brennoms/Arduino-sistema-embarcado-para-reservatorios/assets/20261112 (4).jpg

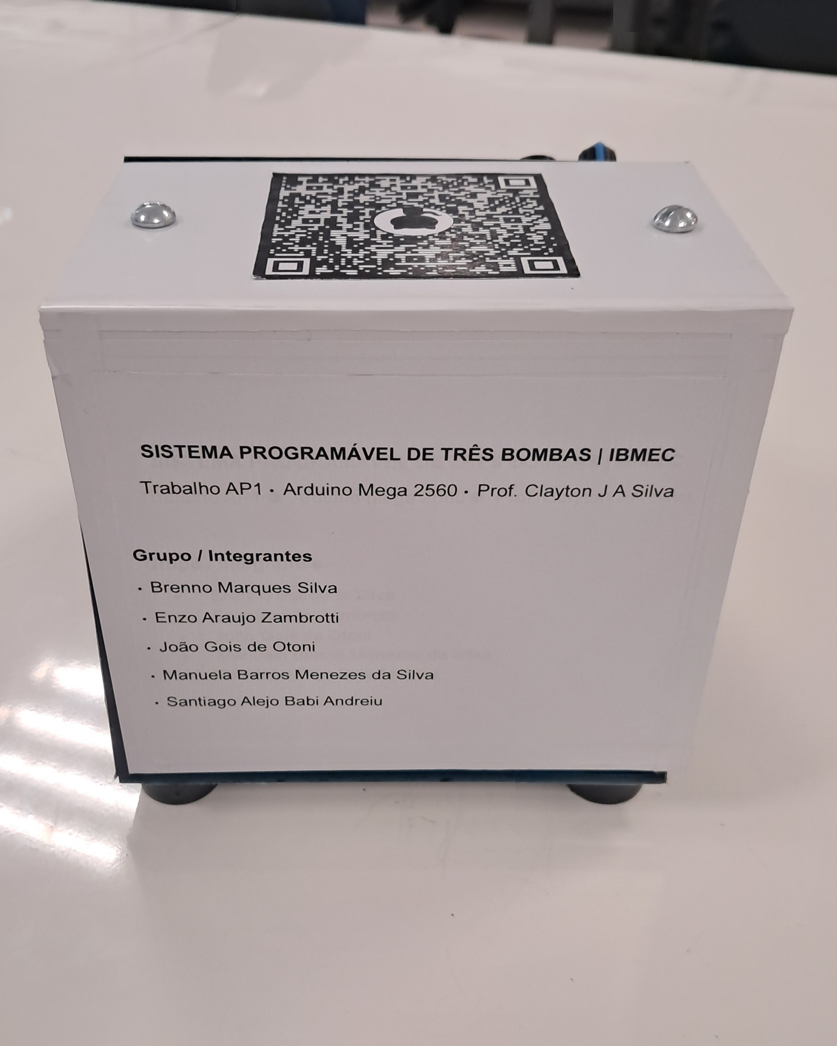
assets/20261112 (4).jpg
