brennoms/Arduino-sistema-embarcado-para-reservatorios/assets/20261112 (3).jpg

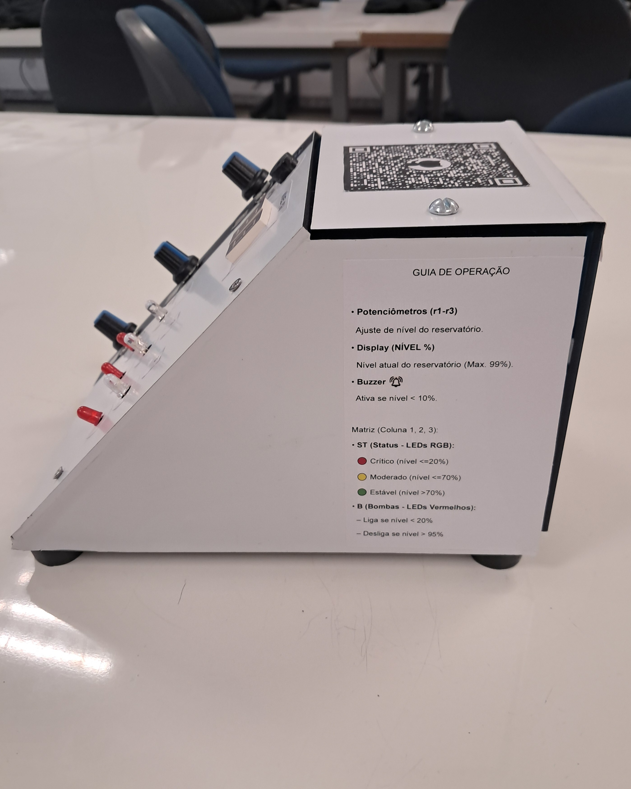
assets/20261112 (3).jpg
