brennoms/Arduino-sistema-embarcado-para-reservatorios/diagramas/case para arduino/creditos.md

## Créditos

Case/suporte para Arduino baseado no modelo
["Arduino Holder"](https://cults3d.com/pt/modelo-3d/ferramentas/arduino-holder/makes),
de [Ivan_N](https://cults3d.com/@Ivan_N).

Licença original: [Creative Commons Atribuição (CC BY 4.0)](https://creativecommons.org/licenses/by/4.0/).

O modelo foi utilizado para impressão 3D neste projeto.
Nenhuma modificação foi feita no modelo original.
