brennoms/Arduino-sistema-embarcado-para-reservatorios/assets/20261112 (1).jpg

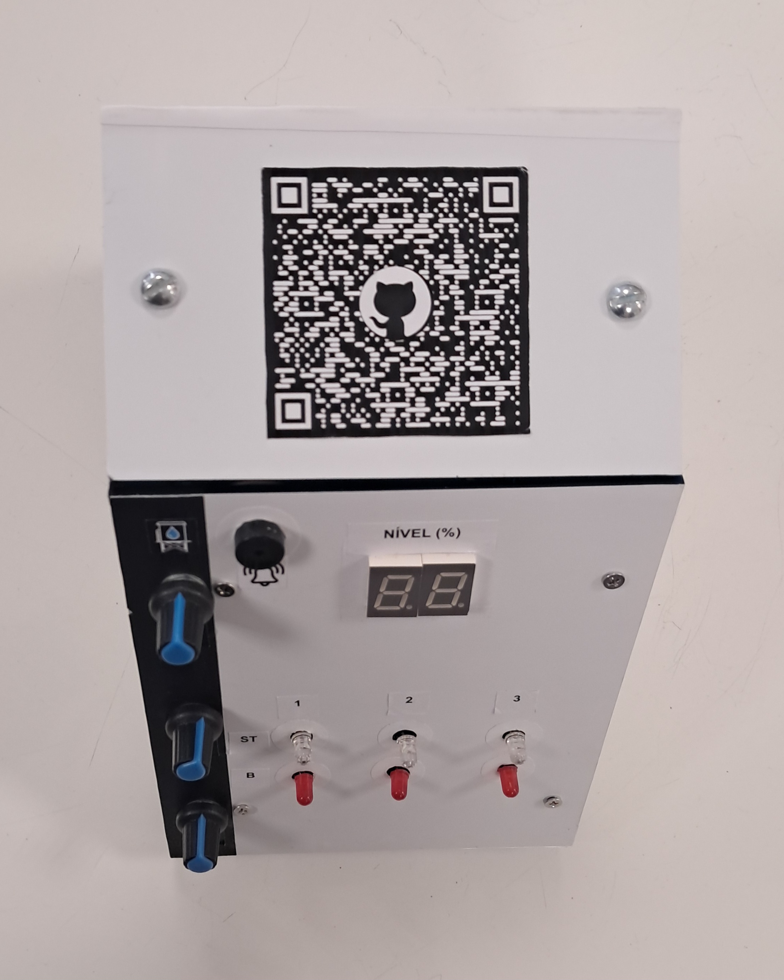
assets/20261112 (1).jpg
