brennoms/Arduino-sistema-embarcado-para-reservatorios/assets/20261112 (2).jpg

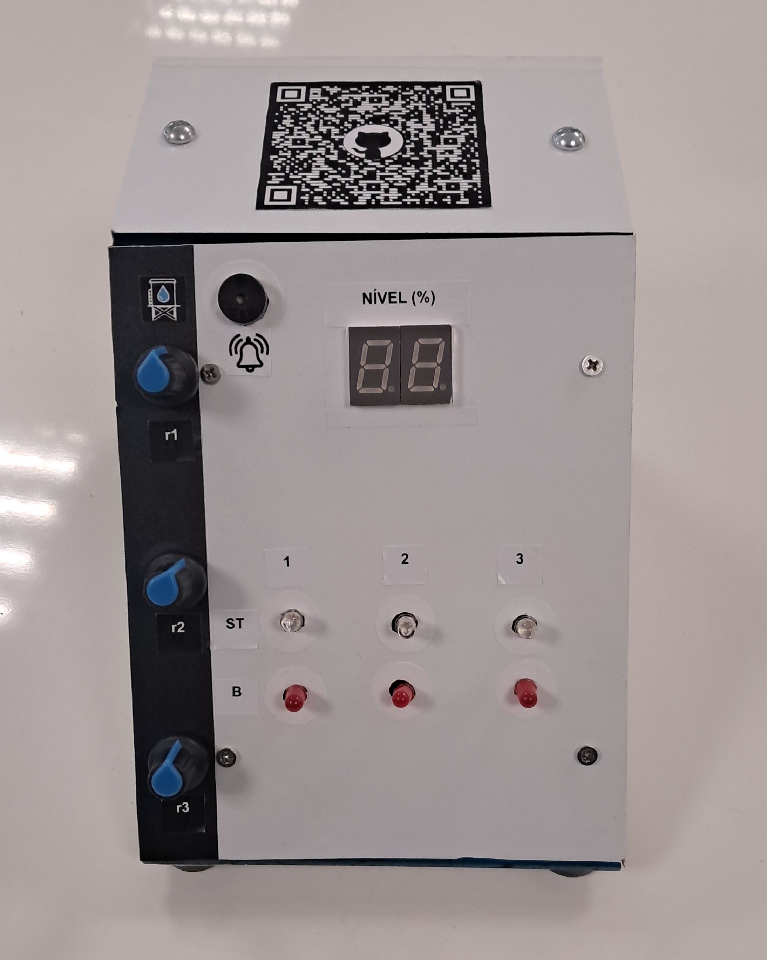
assets/20261112 (2).jpg
