brennoms/Arduino-sistema-embarcado-para-reservatorios/assets/20261112 (5).jpg

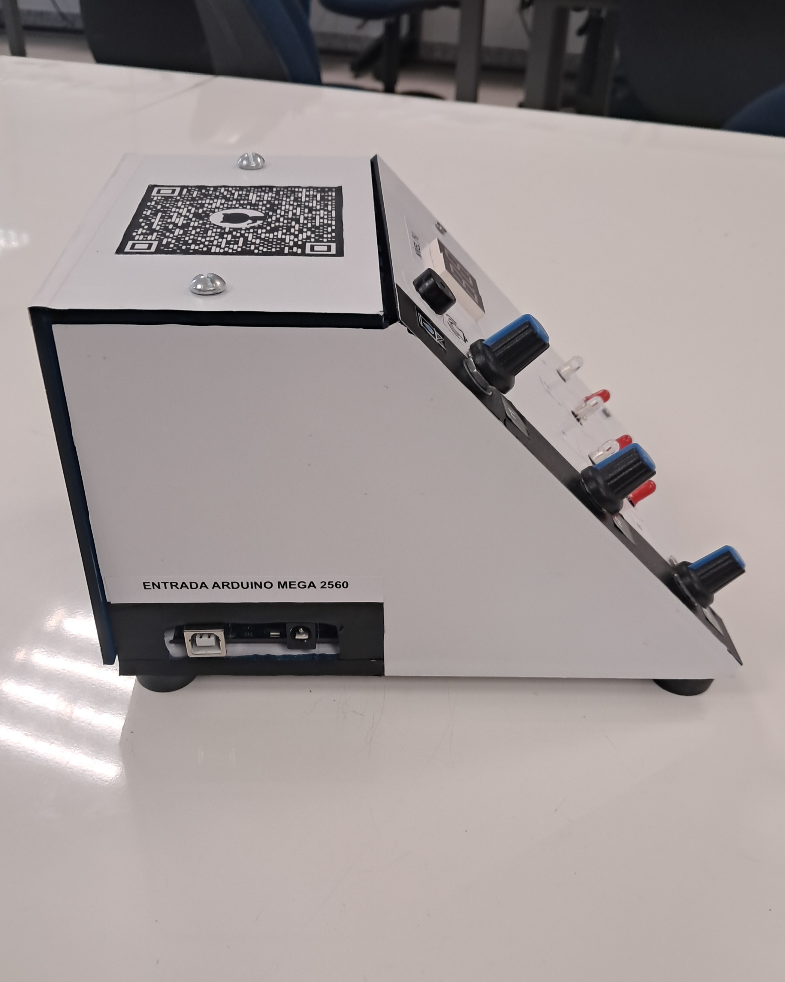
assets/20261112 (5).jpg
