brennoms/Arduino-sistema-embarcado-para-reservatorios/diagramas/Diagrama Arduino Wokwi.jpg

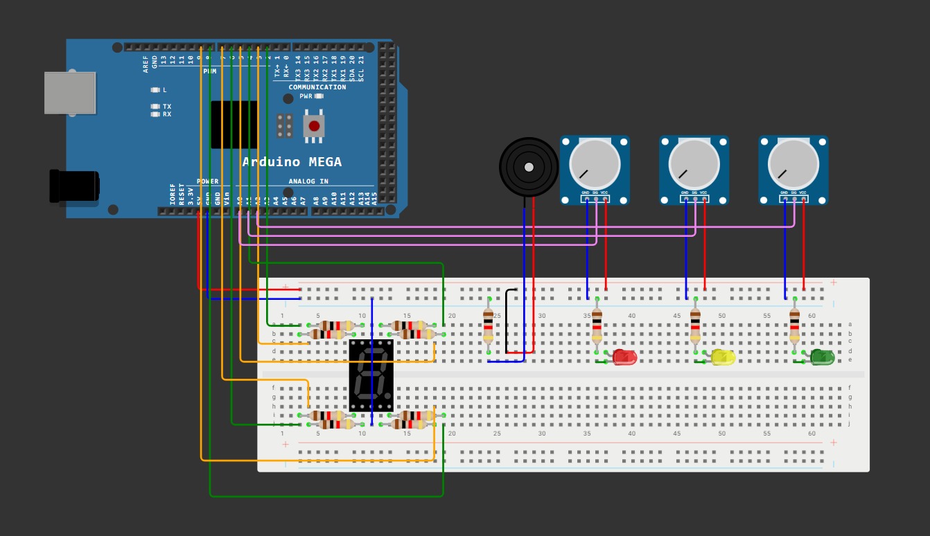
diagramas/Diagrama Arduino Wokwi.jpg
