brennoms/Arduino-sistema-embarcado-para-reservatorios/diagramas/case para arduino/arduino.stl

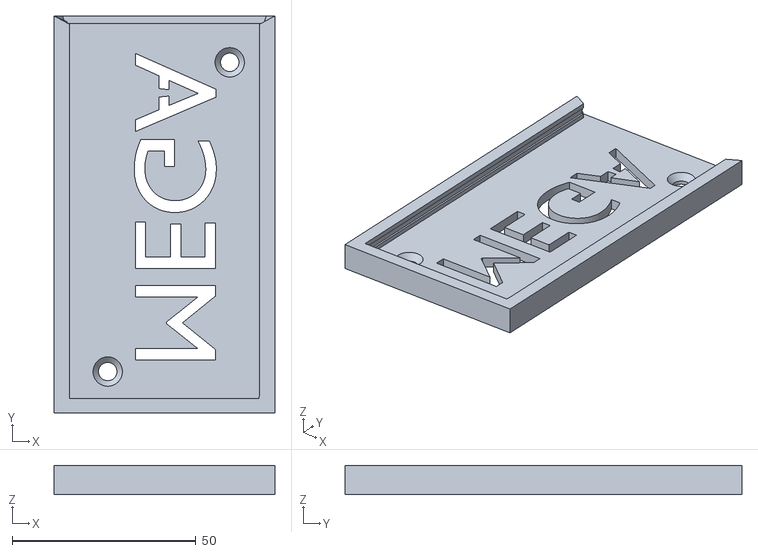
[picture p7: CAD file, 2026-11-08]
diagramas/case para arduino/arduino.stl
60.0 x 108.0 x 7.90
