brennoms/Arduino-sistema-embarcado-para-reservatorios/diagramas/Plano de corte.dxf

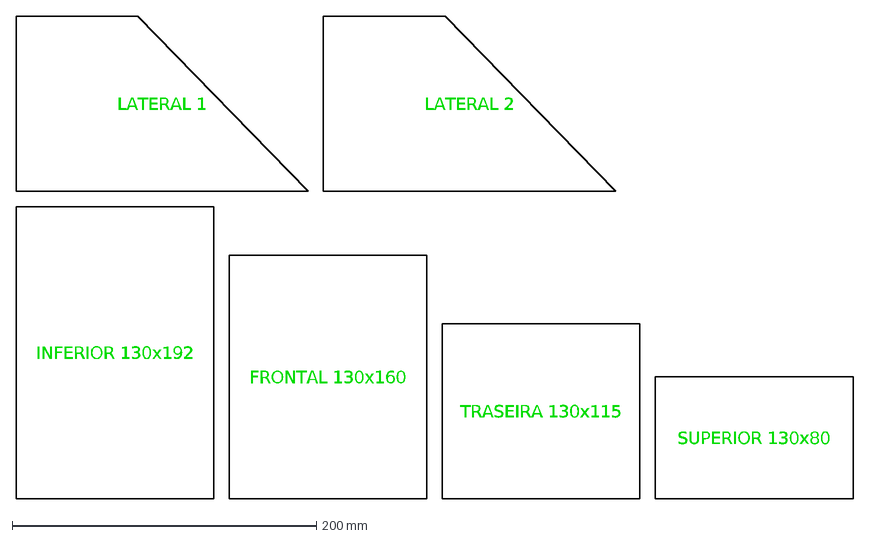
[picture p8: CAD file, 2026-11-06]
diagramas/Plano de corte.dxf
INFERIOR 130x192
FRONTAL 130x160
TRASEIRA 130x115
SUPERIOR 130x80
LATERAL 1
LATERAL 2
