brennoms/Arduino-sistema-embarcado-para-reservatorios/diagramas/diagrama_ligacoes.pdf

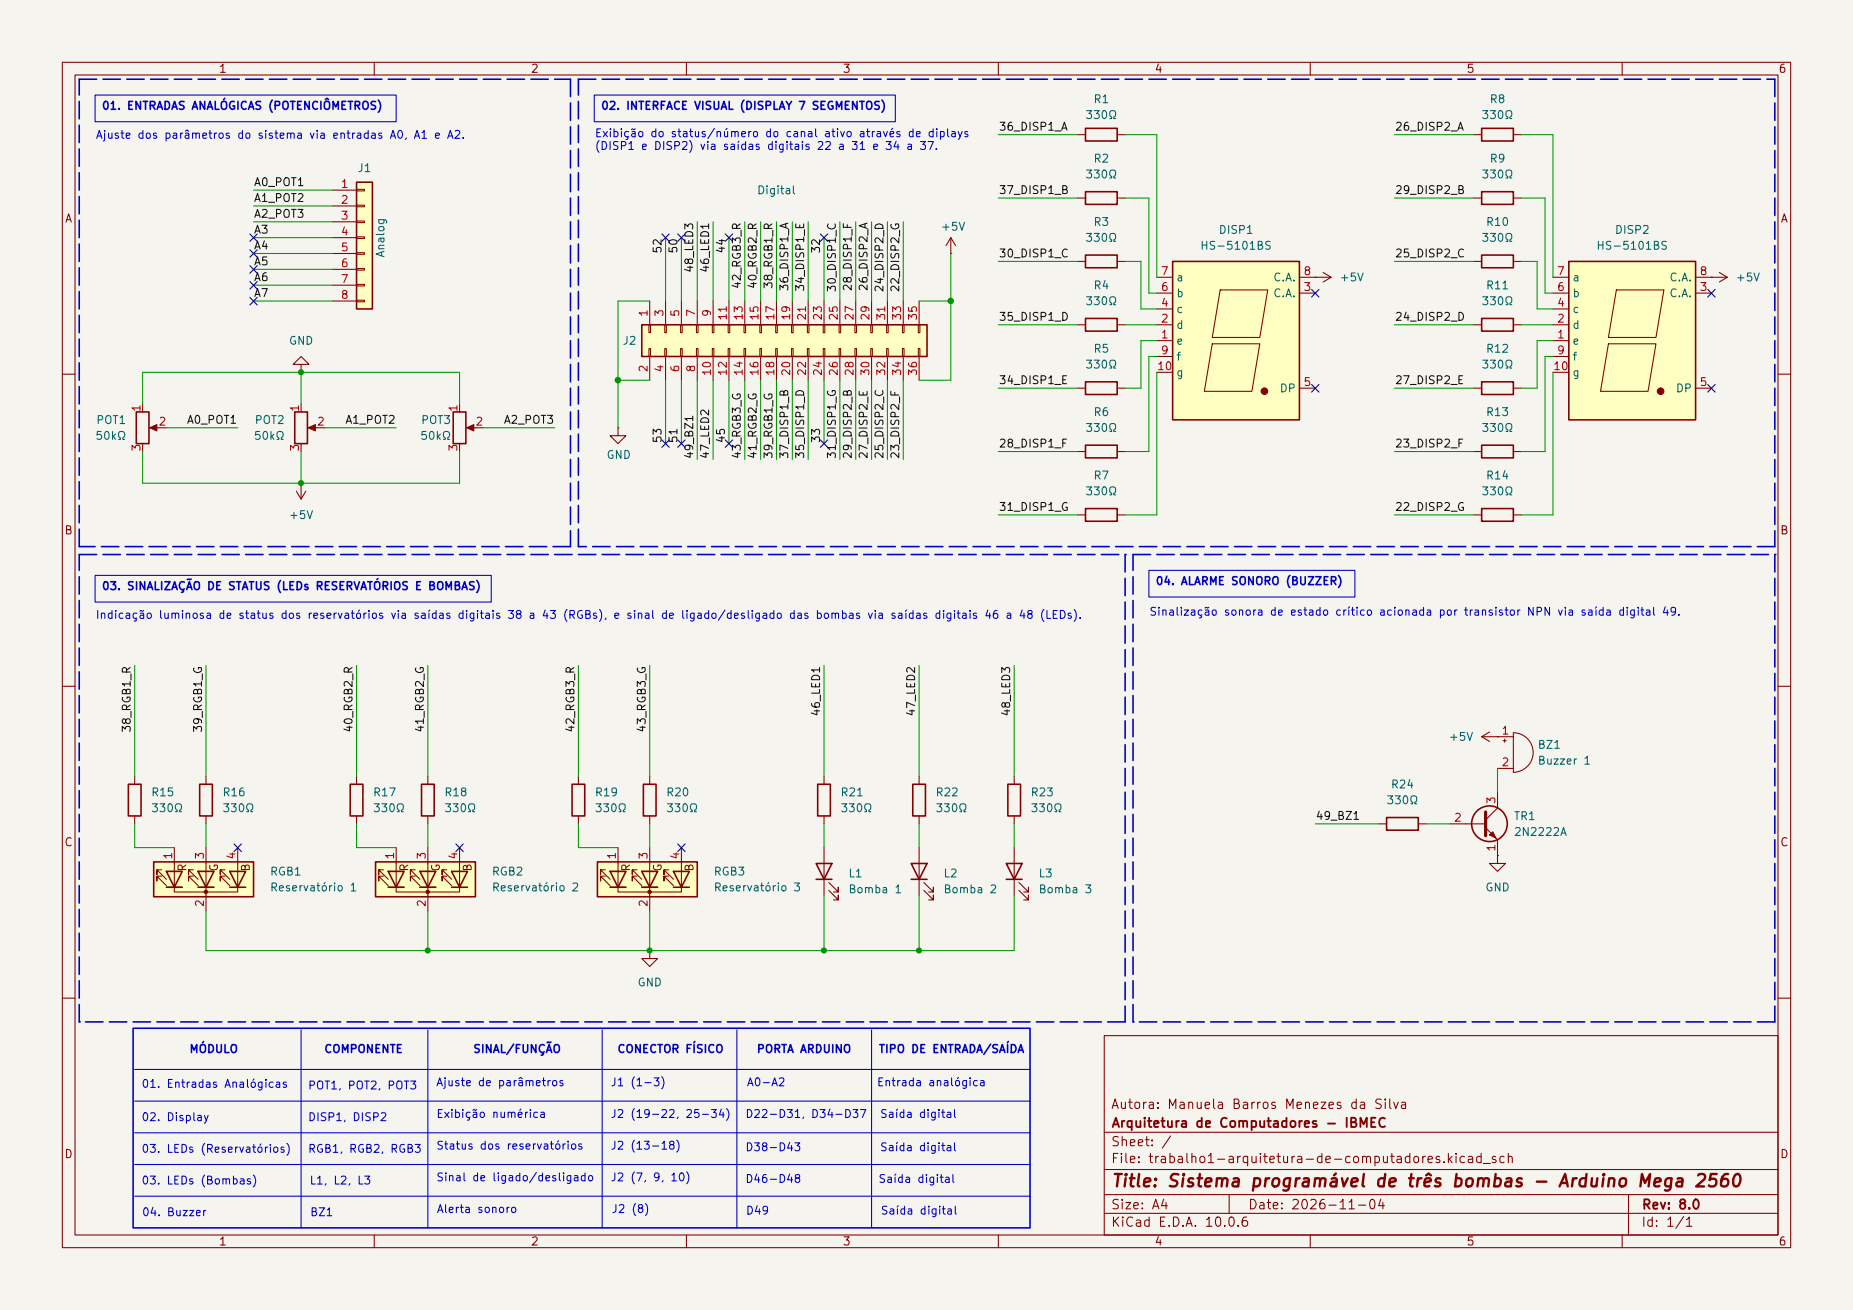
[picture p9: page 1]
