brennoms/Arduino-sistema-embarcado-para-reservatorios/diagramas/Trabalho 1 - Arquitetura de Computadores.pdf

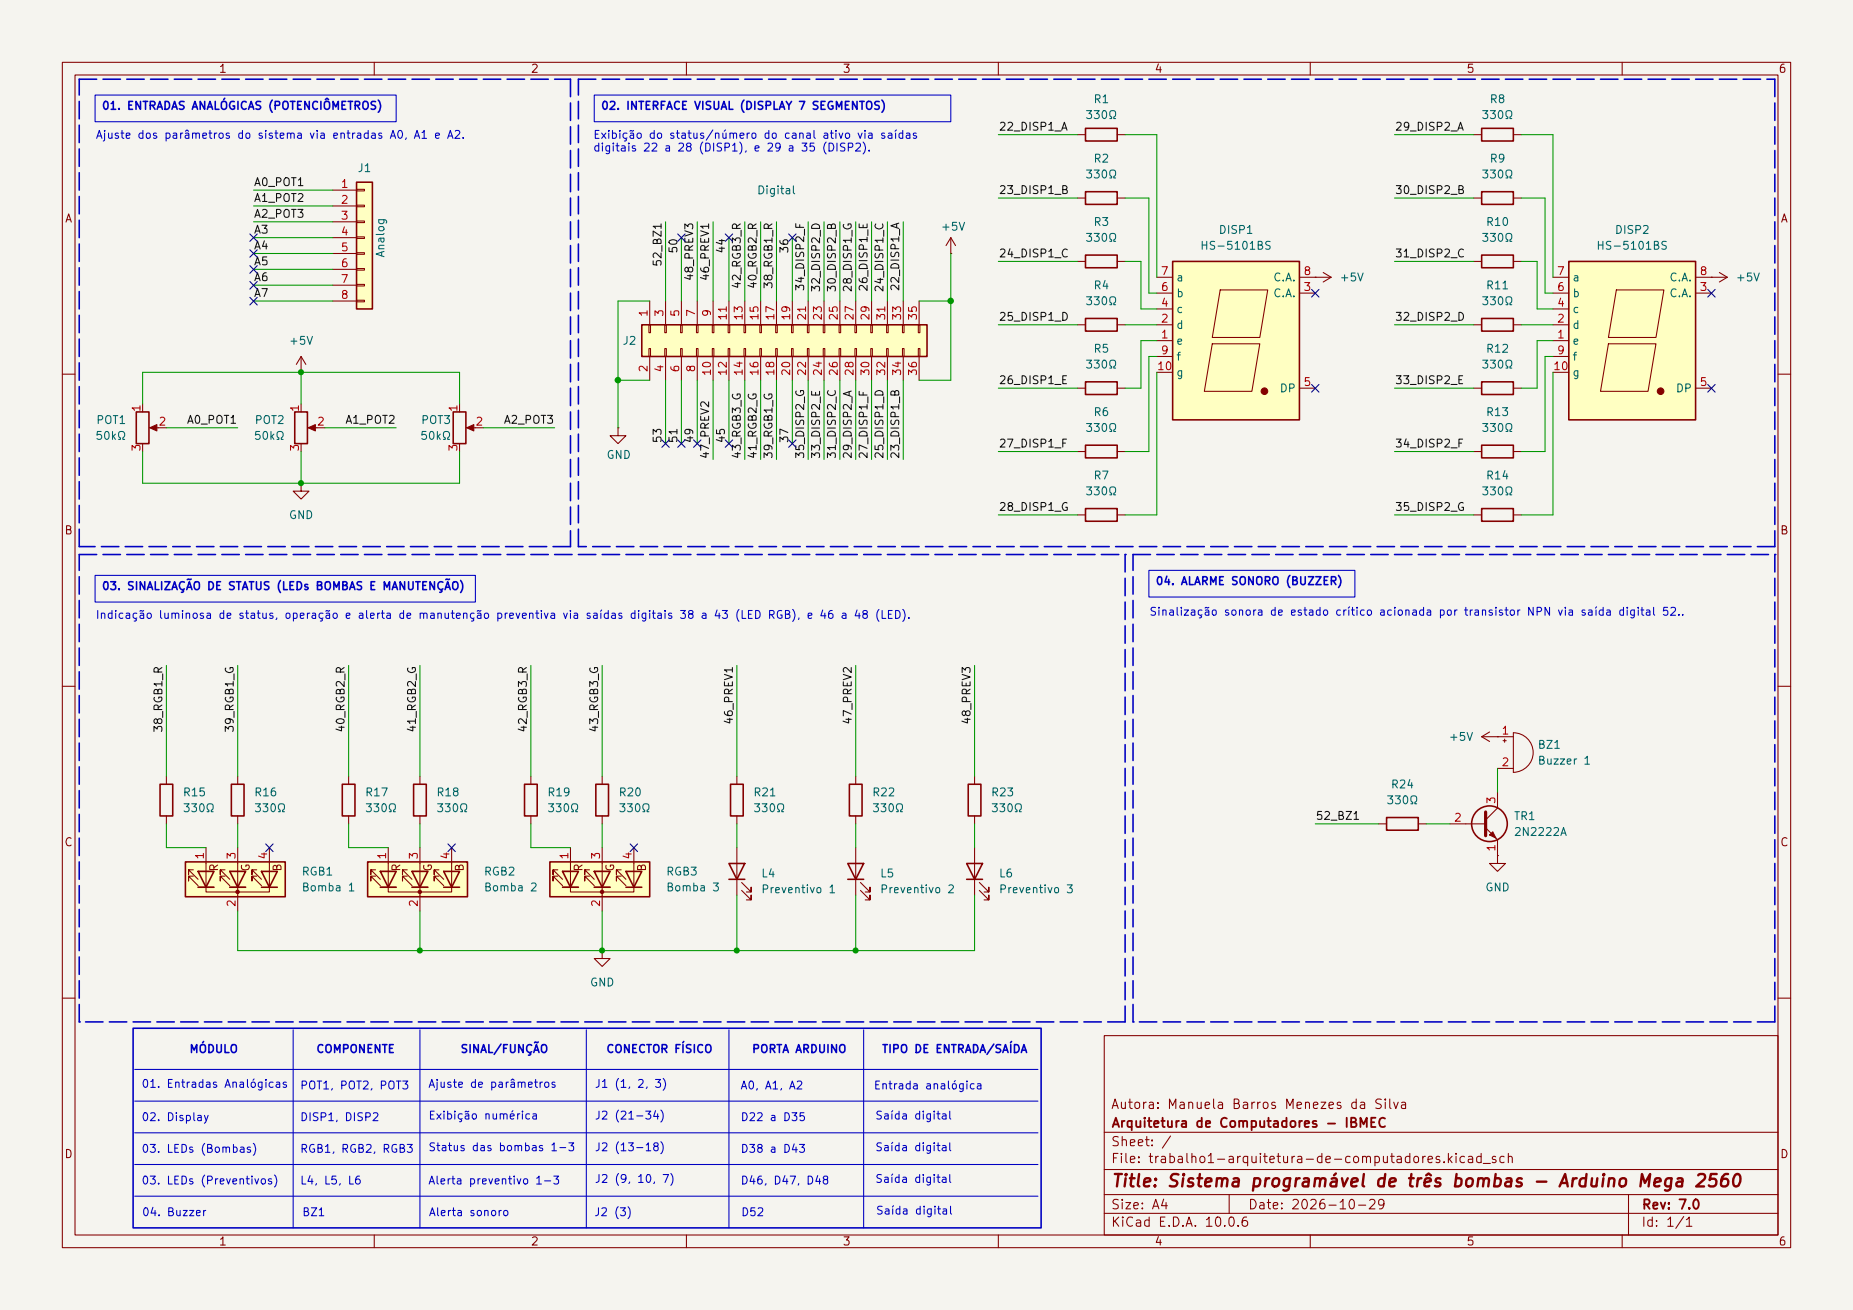
[picture p10: page 1]
