brennoms/Arduino-sistema-embarcado-para-reservatorios/diagramas/projeto kicad/trabalho1-arquitetura-de-computadores.kicad_sch

## KiCad design diagramas/projeto kicad/trabalho1-arquitetura-de-computadores.kicad_sch (2026-11-06)

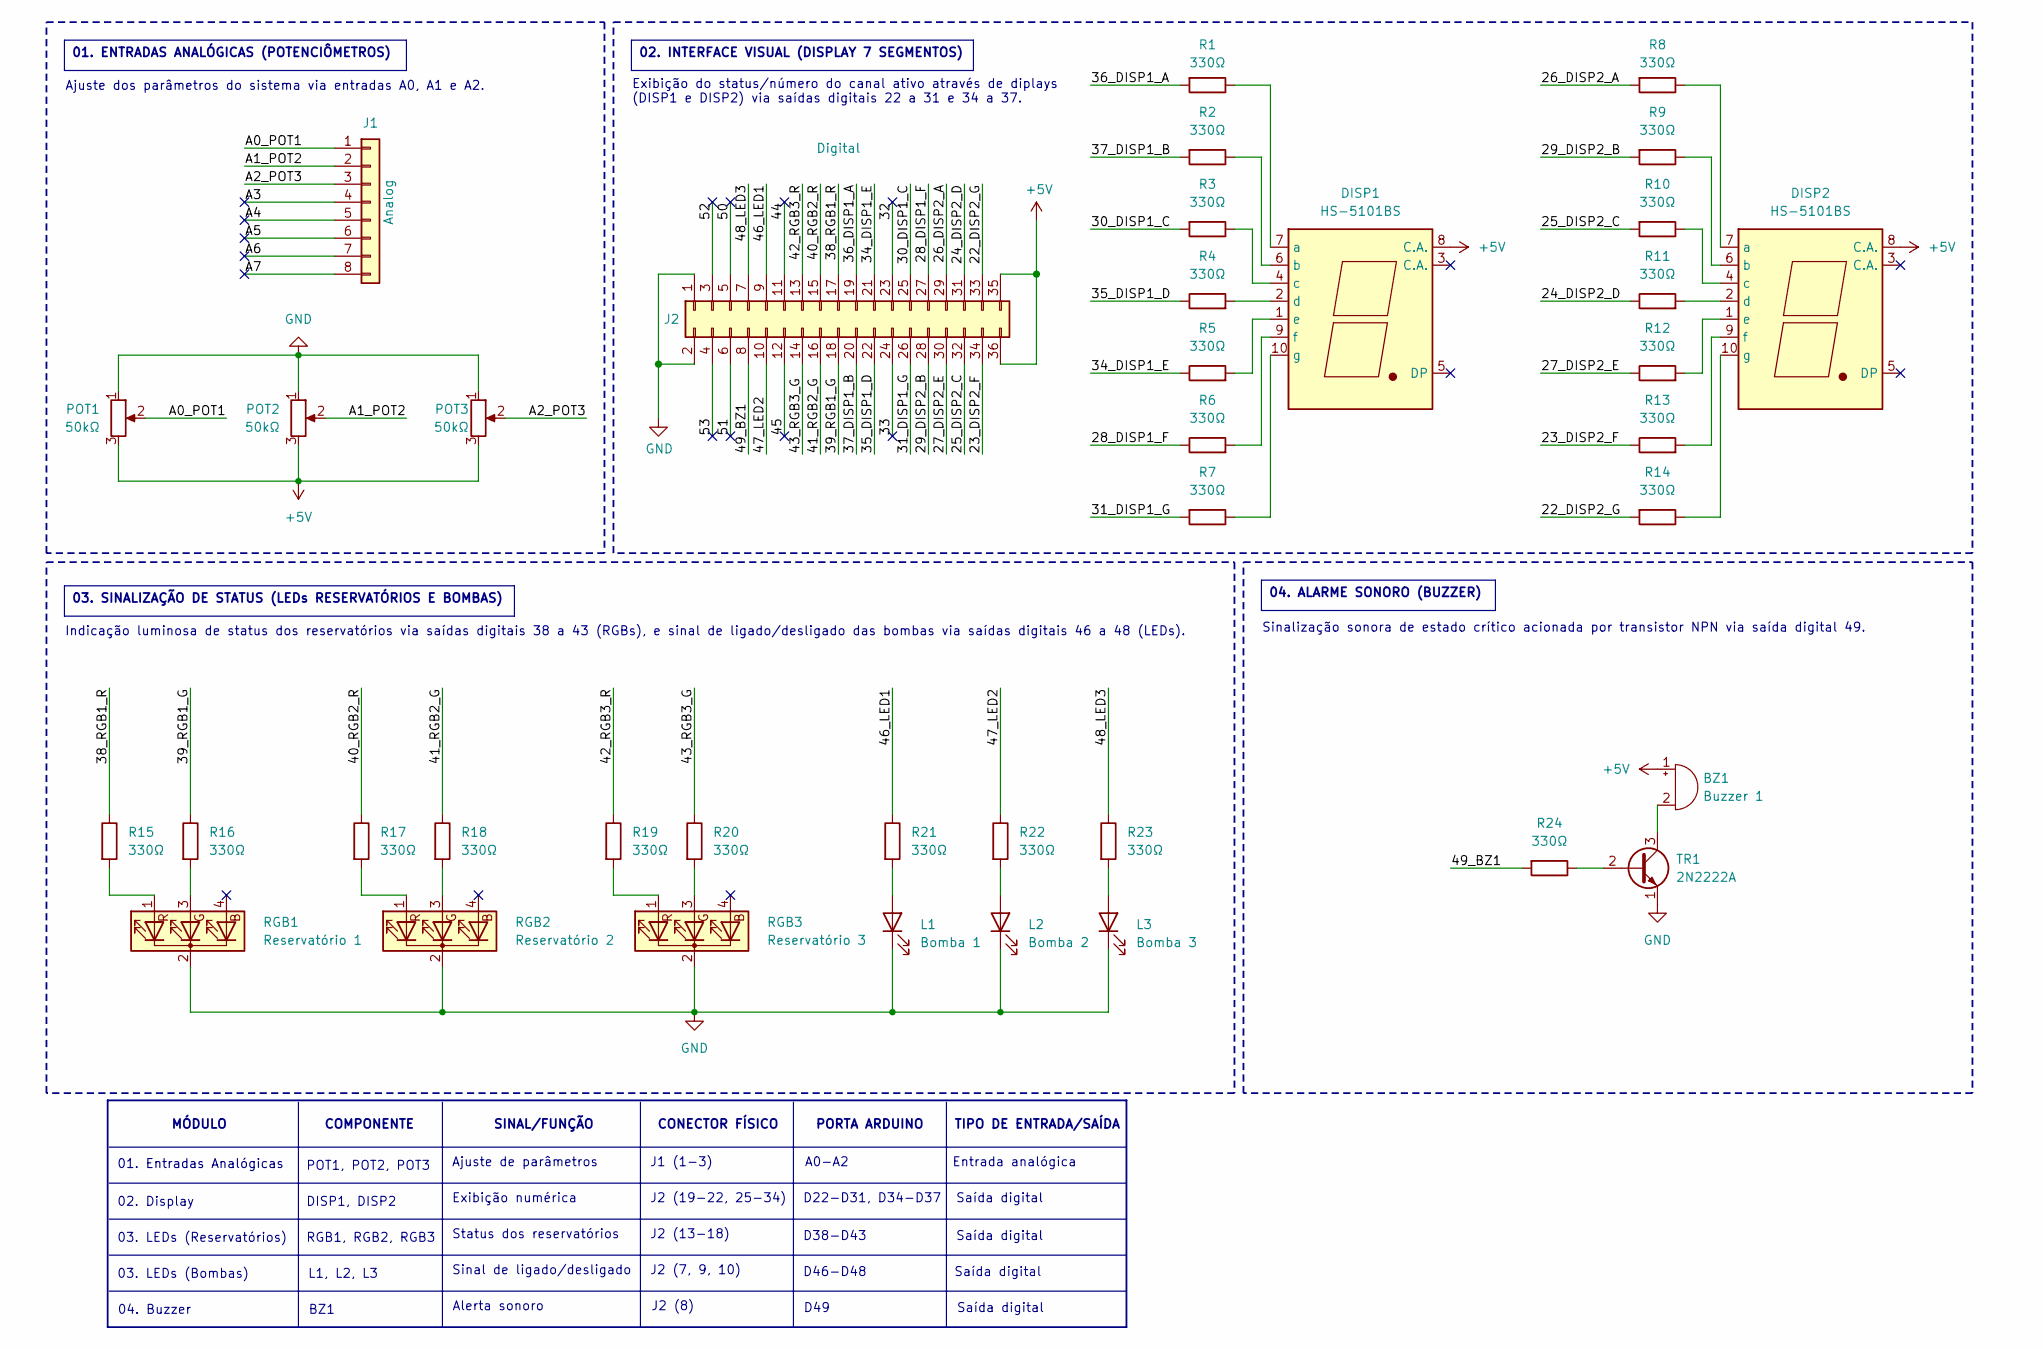
[picture p11: schematic trabalho1-arquitetura-de-computadores.kicad_sch]

Parts:
BZ1: Buzzer 1
DISP1, DISP2: HS-5101BS; 7SegmentLED_LTS6760_LTS6780
J1: Analog; PinSocket_1x08_P2.54mm_Vertical
J2: Digital; PinSocket_2x18_P2.54mm_Vertical
L1: Bomba 1
L2: Bomba 2
L3: Bomba 3
POT1: 50kΩ; TSSOP-20_4.4x6.5mm_P0.65mm
POT2, POT3: 50kΩ
R1, R2, R3, R4, R5, R6, R7, R8, R9, R10, R11, R12, R13, R14, R16, R17, R18, R19, R20, R21, R22, R23: 330Ω
R15: 330Ω; 7SegmentLED_LTS6760_LTS6780
R24: 330Ω; TO-92_Inline
RGB1: Reservatório 1; TO-92_Inline
RGB2: Reservatório 2
RGB3: Reservatório 3
TR1: 2N2222A; TO-92_Inline

Connections:
22_DISP2_G: J2.33, R14.2
23_DISP2_F: J2.34, R13.1
24_DISP2_D: J2.31, R11.1
25_DISP2_C: J2.32, R10.2
26_DISP2_A: J2.29, R8.2
27_DISP2_E: J2.30, R12.1
28_DISP1_F: J2.27, R6.1
29_DISP2_B: J2.28, R9.2
30_DISP1_C: J2.25, R3.2
31_DISP1_G: J2.26, R7.2
32: J2.23
33: J2.24
34_DISP1_E: J2.21, R5.1
35_DISP1_D: J2.22, R4.1
36_DISP1_A: J2.19, R1.2
37_DISP1_B: J2.20, R2.2
38_RGB1_R: J2.17, R15.1
39_RGB1_G: J2.18, R16.1
40_RGB2_R: J2.15, R17.1
41_RGB2_G: J2.16, R18.1
42_RGB3_R: J2.13, R19.1
43_RGB3_G: J2.14, R20.1
44: J2.11
45: J2.12
46_LED1: J2.9, R21.1
47_LED2: J2.10, R22.1
48_LED3: J2.7, R23.1
49_BZ1: J2.8, R24.2
50: J2.5
51: J2.6
52: J2.3
53: J2.4
+5V: BZ1.1 (+), DISP1.8 (C.A.), DISP2.8 (C.A.), J2.35, J2.36, POT1.3, POT2.3, POT3.3
A0_POT1: J1.1, POT1.2
A1_POT2: J1.2, POT2.2
A2_POT3: J1.3, POT3.2
A3: J1.4
A4: J1.5
A5: J1.6
A6: J1.7
A7: J1.8
GND: J2.1, J2.2, L1.1 (K), L2.1 (K), L3.1 (K), POT1.1, POT2.1, POT3.1, RGB1.2 (K), RGB2.2 (K), RGB3.2 (K), TR1.1 (E)
unnamed: BZ1.2 (-), TR1.3 (C)
unnamed: DISP1.1 (e), R5.2
unnamed: DISP1.2 (d), R4.2
unnamed: DISP1.4 (c), R3.1
unnamed: DISP1.6 (b), R2.1
unnamed: DISP1.7 (a), R1.1
unnamed: DISP1.9 (f), R6.2
unnamed: DISP1.10 (g), R7.1
unnamed: DISP2.1 (e), R12.2
unnamed: DISP2.2 (d), R11.2
unnamed: DISP2.4 (c), R10.1
unnamed: DISP2.6 (b), R9.1
unnamed: DISP2.7 (a), R8.1
unnamed: DISP2.9 (f), R13.2
unnamed: DISP2.10 (g), R14.1
unnamed: L1.2 (A), R21.2
unnamed: L2.2 (A), R22.2
unnamed: L3.2 (A), R23.2
unnamed: R15.2, RGB1.1 (RA)
unnamed: R16.2, RGB1.3 (GA)
unnamed: R17.2, RGB2.1 (RA)
unnamed: R18.2, RGB2.3 (GA)
unnamed: R19.2, RGB3.1 (RA)
unnamed: R20.2, RGB3.3 (GA)
unnamed: R24.1, TR1.2 (B)

Notes on the sheet:
PORTA ARDUINO
03. LEDs (Bombas)
Ajuste de parâmetros
TIPO DE ENTRADA/SAÍDA
L1, L2, L3
D46-D48
BZ1
MÓDULO
J1 (1-3)
Ajuste dos parâmetros do sistema via entradas A0, A1 e A2.
04. Buzzer
Sinalização sonora de estado crítico acionada por transistor NPN via saída digital 49.
01. Entradas Analógicas
J2 (8)
03. LEDs (Reservatórios)
CONECTOR FÍSICO
Indicação luminosa de status dos reservatórios via saídas digitais 38 a 43 (RGBs), e sinal de ligado/desligado das bombas via saídas digitais 46 a 48 (LEDs).
J2 (13-18)
RGB1, RGB2, RGB3
Saída digital
D38-D43
J2 (19-22, 25-34)
D49
Exibição numérica
A0-A2
Alerta sonoro
Exibição do status/número do canal ativo através de diplays (DISP1 e DISP2) via saídas digitais 22 a 31 e 34 a 37.
Sinal de ligado/desligado
D22-D31, D34-D37
02. Display
Entrada analógica
J2 (7, 9, 10)
COMPONENTE
Status dos reservatórios
DISP1, DISP2
POT1, POT2, POT3
SINAL/FUNÇÃO
03. SINALIZAÇÃO DE STATUS (LEDs RESERVATÓRIOS E BOMBAS)
02. INTERFACE VISUAL (DISPLAY 7 SEGMENTOS)
04. ALARME SONORO (BUZZER)
01. ENTRADAS ANALÓGICAS (POTENCIÔMETROS)
