brennoms/Arduino-sistema-embarcado-para-reservatorios/scripts/ArquiteturaSimulada.ino

//Autor: Brenno Marques Silva @brennoms

#include <Arduino.h>
#include <EEPROM.h>
#include <stdint.h>
#include <stdbool.h>
#include <string.h>
#include <stdlib.h>

// ============================================================================
// ARQUITETURA SIMULADA — SISTEMA PROGRAMÁVEL DE TRÊS BOMBAS (COM SECDED)
//
// Palavra lógica da ISA: 18 bits
//   bits 17..14 -> opcode (4 bits)
//   bits 13..7  -> operando 1 (7 bits)
//   bits 6..0   -> operando 2 (7 bits)
//
// Proteção de Memória SECDED (Hamming Estendido 24,18):
//   - 18 bits de dados da ISA (D0..D17)
//   - 5 bits de paridade de Hamming (P1, P2, P4, P8, P16) nas posições 1,2,4,8,16
//   - 1 bit de paridade global (P0) na posição 0
//   - Palavra física armazenada em MEM_PROG: 24 bits (bits 23..0 do uint32_t)
//
// Memória de programa:
//   128 posições: 0x00 .. 0x7F
//   uma palavra física de 24 bits (18 bits ISA + 6 bits ECC) por posição
// ============================================================================

// ============================== Constantes =================================
#define BITS_OPCODE        4
#define BITS_OPERANDO      7
#define BITS_PALAVRA       18
#define BITS_ECC           6
#define BITS_FISICOS       24
#define TAM_MEMORIA        128
#define VALOR_MAX_OPERANDO 0x7F
#define MAX_PERCENTUAL     100

// Ajustado para 127 para manter coerência estrita com o campo OP1 de 7 bits (12,7 s).
#define MAX_WAIT_TICKS     127
#define WAIT_MS            100UL

#define OPCODE_SHIFT       14
#define OPERANDO1_SHIFT    7
#define MASCARA_7_BITS     0x7FUL
#define MASCARA_PALAVRA    0x3FFFFUL
#define MASCARA_FISICA     0xFFFFFFUL

#define LINE_BUFFER_SIZE   96
#define EEPROM_MAGIC       0xA55A
#define EEPROM_HEADER_SIZE 4

// Limiares de nível para os LEDs RGB
#define LIMIAR_CRITICO     20
#define LIMIAR_RAZOAVEL    70

// ================================ Pinagem ===================================
const uint8_t PIN_NIVEL[3] = {A0, A1, A2};
const uint8_t PIN_BOMBA[3] = {46, 47, 48};

// Pinos dos 3 LEDs RGB (canais vermelho e verde)
const uint8_t PIN_RGB_R[3] = {38, 40, 42};
const uint8_t PIN_RGB_G[3] = {39, 41, 43};

const uint8_t PIN_BUZZER = 49;
const uint8_t PIN_DISPLAY_DEZENAS[7] = {36, 37, 30, 35, 34, 28, 31}; // DISP1: a,b,c,d,e,f,g
const uint8_t PIN_DISPLAY_UNIDADES[7] = {26, 29, 25, 24, 27, 23, 22}; // DISP2: a,b,c,d,e,f,g

// Os displays HS-5101BS do esquema têm anodo comum.
#define DISPLAY_ACTIVE_HIGH false

// ============================= Códigos da ISA ===============================
enum Opcode : uint8_t {
    OP_READ = 0,
    OP_ON,
    OP_OFF,
    OP_ALARM,
    OP_LED,
    OP_INFO,
    OP_SILENCE,
    OP_LEDOFF,
    OP_CMP,
    OP_JMP,
    OP_JL,
    OP_JE,
    OP_JG,
    OP_WAIT,
    OP_HALT,
    OP_REG = 15
};

const Opcode OP_INVALID = (Opcode)16;
const uint8_t REG_SUBOP_CMP = 0;
const uint8_t REG_SUBOP_JUMP = 1;
const uint8_t REG_SUBOP_SUM = 2;

const char *NOME_OPCODE[16] = {
    "READ", "ON", "OFF", "ALARM", "LED", "INFO", "SILENCE", "LEDOFF",
    "CMP", "JMP", "JL", "JE", "JG", "WAIT", "HALT", "REG"
};

// ============================ Sinais de memória =============================
enum SinalMemoria : uint8_t {
    MEM_NENHUM = 0,
    MEM_LEITURA,
    MEM_ESCRITA
};

// ============================ Estados do SECDED =============================
enum StatusSECDED : uint8_t {
    ECC_OK = 0,
    ECC_SEC_CORRIGIDO,
    ECC_DED_ERRO_DUPLO
};

const char *NOME_ECC[] = {
    "OK (Sem Erro)",
    "SEC (1 Erro Corrigido)",
    "DED (2 Erros Detectados - Falha Critica)"
};

// Mapeamento dos 18 bits de dados (D0..D17) para as posições de Hamming (1..23),
// pulando as potências de 2 (1, 2, 4, 8, 16).
const uint8_t POS_DADOS_HAMMING[BITS_PALAVRA] = {
    3,  5,  6,  7,  9,  10, 11, 12, 13,
    14, 15, 17, 18, 19, 20, 21, 22, 23
};

// ============================== Estados da UC ===============================
enum ModoExecucao : uint8_t {
    MODO_CARGA = 0,
    MODO_PARADO,
    MODO_STEP,
    MODO_AUTO,
    MODO_WAIT,
    MODO_HALT,
    MODO_ERRO
};

const char *NOME_MODO[] = {
    "CARGA", "PARADO", "STEP", "AUTO", "WAIT", "HALT", "ERRO"
};

enum FaseUC : uint8_t {
    FASE_OCIOSA = 0,
    FASE_BUSCA,
    FASE_DECODIFICA,
    FASE_EXECUTA
};

enum CorRGB : uint8_t {
    RGB_OFF = 0,
    RGB_VERMELHO,
    RGB_AMARELO,
    RGB_VERDE
};

// ============================= Registradores =================================
uint8_t  PC = 0;                       // 7 bits efetivos
uint8_t  MAR = 0;                      // endereço de memória
uint32_t MBR = 0;                      // palavra lógica de 18 bits entregue pela memória
uint32_t MBR_RAW = 0;                  // palavra física de 24 bits lida antes/depois do ECC
uint32_t IR = 0;                       // palavra completa da instrução (18 bits efetivos)

// Registradores de diagnóstico do controlador SECDED
uint8_t      ECC_SINDROME = 0;         // 5 bits (0..23)
uint8_t      ECC_PARIDADE_GLOBAL = 0;  // 1 bit (0 ou 1)
StatusSECDED ECC_STATUS = ECC_OK;
uint16_t     CONTADOR_SEC = 0;         // total de erros simples corrigidos desde o LOAD
uint16_t     CONTADOR_DED = 0;         // total de erros duplos detectados desde o LOAD

int16_t  ACC = 0;                      // resultado assinado; faixa útil -100..100
int16_t  REG = 0;                      // registrador de uso geral assinado
uint8_t  OPCODE_REG = OP_REG;
uint8_t  OP1 = 0;
uint8_t  OP2 = 0;

uint8_t  NIVEL[3] = {0, 0, 0};
bool     NIVEL_VALIDO[3] = {false, false, false};

bool FLAG_L = false;
bool FLAG_Z = false;
bool FLAG_G = false;
bool COMPARACAO_VALIDA = false;
bool FLAG_REG = false;                 // CMPREG: REG < n
bool COMPARACAO_REG_VALIDA = false;

bool BOMBA_LIGADA[3] = {false, false, false};
bool LED_HABILITADO[3] = {false, false, false};
bool ALARME_CORRETIVO[3] = {false, false, false};

// ================================ Memória ===================================
// Cada posição armazena 24 bits físicos: [23..1: Hamming(23,18)] + [0: Paridade Global P0]
uint32_t MEM_PROG[TAM_MEMORIA] = {0};
bool MEM_OCUPADA[TAM_MEMORIA] = {false};

uint16_t instrucao_atual = 0;
bool programaFinalizado = false;

uint16_t enderecoEEPROMInstrucao(uint8_t endereco) {
    return EEPROM_HEADER_SIZE + ((uint16_t)endereco * sizeof(uint32_t));
}

void gravarUInt32EEPROM(uint16_t endereco, uint32_t valor) {
    for (uint8_t i = 0; i < sizeof(uint32_t); ++i) {
        EEPROM.update(endereco + i, (uint8_t)(valor >> (i * 8)));
    }
}

uint32_t lerUInt32EEPROM(uint16_t endereco) {
    uint32_t valor = 0;
    for (uint8_t i = 0; i < sizeof(uint32_t); ++i) {
        valor |= (uint32_t)EEPROM.read(endereco + i) << (i * 8);
    }
    return valor;
}

void limparProgramaPersistido() {
    EEPROM.update(0, 0);
    EEPROM.update(1, 0);
    EEPROM.update(2, 0);
    EEPROM.update(3, 0);
}

void persistirPrograma() {
    EEPROM.update(0, 0);
    EEPROM.update(1, 0);
    EEPROM.update(2, instrucao_atual & 0xFF);
    EEPROM.update(3, instrucao_atual >> 8);
    for (uint16_t endereco = 0; endereco < instrucao_atual; ++endereco) {
        gravarUInt32EEPROM(enderecoEEPROMInstrucao((uint8_t)endereco), MEM_PROG[endereco]);
    }
    EEPROM.update(0, (uint8_t)(EEPROM_MAGIC & 0xFF));
    EEPROM.update(1, (uint8_t)(EEPROM_MAGIC >> 8));
}

bool restaurarProgramaPersistido() {
    uint16_t magic = (uint16_t)EEPROM.read(0) | ((uint16_t)EEPROM.read(1) << 8);
    uint16_t quantidade = (uint16_t)EEPROM.read(2) | ((uint16_t)EEPROM.read(3) << 8);

    if (magic != EEPROM_MAGIC || quantidade == 0 || quantidade > TAM_MEMORIA) {
        return false;
    }

    limparMemoria();
    for (uint16_t endereco = 0; endereco < quantidade; ++endereco) {
        MEM_PROG[endereco] = lerUInt32EEPROM(enderecoEEPROMInstrucao((uint8_t)endereco)) & MASCARA_FISICA;
        MEM_OCUPADA[endereco] = true;
    }
    instrucao_atual = quantidade;
    programaFinalizado = true;
    return true;
}

// ============================== Controle ====================================
ModoExecucao MODO = MODO_CARGA;
FaseUC FASE = FASE_OCIOSA;
bool CLOCK = false;

uint32_t waitTermino = 0;
ModoExecucao modoAposWait = MODO_PARADO;
bool stepSolicitado = false;
uint8_t ultimoPercentual = 0;
bool displayAtivo = false;

char linhaSerial[LINE_BUFFER_SIZE];
uint8_t posLinhaSerial = 0;

// ============================= ULA ===========================================
enum OperacaoULA : uint8_t {
    ULA_NENHUMA = 0,
    ULA_SUBTRACAO
};

OperacaoULA ULA_OPERACAO = ULA_NENHUMA;
int16_t ULA_A = 0;
int16_t ULA_B = 0;
int16_t ULA_RESULTADO = 0;

// ============================== Utilidades ==================================
void imprimirHex2(uint8_t valor) {
    if (valor < 0x10) Serial.print('0');
    Serial.print(valor, HEX);
}

void imprimirEndereco(uint8_t endereco) {
    Serial.print(F("0x"));
    imprimirHex2(endereco);
}

void imprimirBinario18(uint32_t palavra) {
    palavra &= MASCARA_PALAVRA;
    for (int8_t bit = BITS_PALAVRA - 1; bit >= 0; --bit) {
        Serial.print((palavra >> bit) & 1UL);
    }
}

void imprimirBinario24(uint32_t palavraFisica) {
    palavraFisica &= MASCARA_FISICA;
    for (int8_t bit = BITS_FISICOS - 1; bit >= 0; --bit) {
        Serial.print((palavraFisica >> bit) & 1UL);
    }
}

uint32_t codificarComplemento2_18(int32_t valor) {
    return ((uint32_t)valor) & MASCARA_PALAVRA;
}

void imprimirACC18() {
    Serial.print(F("ACC[18b]="));
    imprimirBinario18(codificarComplemento2_18(ACC));
}

void trimInPlace(char *texto) {
    if (texto == NULL) return;

    size_t inicio = 0;
    size_t fim = strlen(texto);

    while (inicio < fim && (texto[inicio] == ' ' || texto[inicio] == '\t' || texto[inicio] == '\r' || texto[inicio] == '\n')) {
        inicio++;
    }

    while (fim > inicio && (texto[fim - 1] == ' ' || texto[fim - 1] == '\t' || texto[fim - 1] == '\r' || texto[fim - 1] == '\n')) {
        fim--;
    }

    if (inicio > 0) {
        memmove(texto, texto + inicio, fim - inicio);
    }

    texto[fim - inicio] = '\0';
}

void removerComentario(char *texto) {
    char *comentario = strchr(texto, ';');
    if (comentario != NULL) {
        *comentario = '\0';
    }
}

void paraMaiusculas(char *texto) {
    for (size_t i = 0; texto[i] != '\0'; ++i) {
        if (texto[i] >= 'a' && texto[i] <= 'z') {
            texto[i] = texto[i] - 'a' + 'A';
        }
    }
}

bool textoVazio(const char *texto) {
    return texto == NULL || texto[0] == '\0';
}

bool parseDecimal(const char *texto, int min, int max, int *saida) {
    if (texto == NULL || texto[0] == '\0' || saida == NULL) {
        return false;
    }

    long valor = 0;
    for (size_t i = 0; texto[i] != '\0'; ++i) {
        char c = texto[i];
        if (c < '0' || c > '9') {
            return false;
        }

        valor = valor * 10L + (c - '0');
        if (valor > max) {
            return false;
        }
    }

    if (valor < min || valor > max) {
        return false;
    }

    *saida = (int)valor;
    return true;
}

bool parseSigned7(const char *texto, int *saida) {
    if (texto == NULL || texto[0] == '\0' || saida == NULL) return false;

    bool negativo = texto[0] == '-';
    const char *digitos = negativo ? texto + 1 : texto;
    if (*digitos == '\0') return false;

    int valor = 0;
    for (size_t i = 0; digitos[i] != '\0'; ++i) {
        if (digitos[i] < '0' || digitos[i] > '9') return false;
        valor = valor * 10 + (digitos[i] - '0');
        if (valor > 64) return false;
    }

    valor = negativo ? -valor : valor;
    if (valor < -64 || valor > 63) return false;

    *saida = valor;
    return true;
}

int hexDigit(char c) {
    if (c >= '0' && c <= '9') return c - '0';
    if (c >= 'A' && c <= 'F') return c - 'A' + 10;
    if (c >= 'a' && c <= 'f') return c - 'a' + 10;
    return -1;
}

bool parseEnderecoHex(const char *texto, uint8_t *saida) {
    if (texto == NULL || saida == NULL) return false;
    if (strlen(texto) != 4) return false;
    if (texto[0] != '0' || (texto[1] != 'X' && texto[1] != 'x')) return false;

    int alto = hexDigit(texto[2]);
    int baixo = hexDigit(texto[3]);
    if (alto < 0 || baixo < 0) return false;

    int valor = (alto << 4) | baixo;
    if (valor < 0 || valor >= TAM_MEMORIA) return false;

    *saida = (uint8_t)valor;
    return true;
}

const char *nomeModoAtual() {
    return NOME_MODO[MODO];
}

// ============================ Módulo SECDED =================================
uint32_t codificarSECDED(uint32_t dados18) {
    dados18 &= MASCARA_PALAVRA;
    uint32_t codificado = 0;

    for (uint8_t i = 0; i < BITS_PALAVRA; ++i) {
        if ((dados18 >> i) & 1UL) {
            codificado |= (1UL << POS_DADOS_HAMMING[i]);
        }
    }

    for (uint8_t k = 0; k < 5; ++k) {
        uint8_t posParidade = (1U << k);
        uint8_t paridade = 0;

        for (uint8_t pos = 1; pos <= 23; ++pos) {
            if (pos != posParidade && (pos & posParidade)) {
                paridade ^= (uint8_t)((codificado >> pos) & 1UL);
            }
        }

        if (paridade) {
            codificado |= (1UL << posParidade);
        }
    }

    uint8_t paridadeGlobal = 0;
    for (uint8_t pos = 1; pos <= 23; ++pos) {
        paridadeGlobal ^= (uint8_t)((codificado >> pos) & 1UL);
    }

    if (paridadeGlobal) {
        codificado |= 1UL;
    }

    return codificado & MASCARA_FISICA;
}

uint32_t extrairDados18(uint32_t palavraFisica24) {
    uint32_t dados18 = 0;
    for (uint8_t i = 0; i < BITS_PALAVRA; ++i) {
        if ((palavraFisica24 >> POS_DADOS_HAMMING[i]) & 1UL) {
            dados18 |= (1UL << i);
        }
    }
    return dados18 & MASCARA_PALAVRA;
}

StatusSECDED decodificarSECDED(uint32_t palavraRecebida, uint32_t *palavraFisicaCorrigida, uint32_t *dados18Saida, uint8_t *sindromeSaida, uint8_t *paridadeGlobalSaida) {
    palavraRecebida &= MASCARA_FISICA;

    uint8_t sindrome = 0;
    for (uint8_t k = 0; k < 5; ++k) {
        uint8_t posParidade = (1U << k);
        uint8_t paridadeGrupo = 0;

        for (uint8_t pos = 1; pos <= 23; ++pos) {
            if (pos & posParidade) {
                paridadeGrupo ^= (uint8_t)((palavraRecebida >> pos) & 1UL);
            }
        }

        if (paridadeGrupo) {
            sindrome |= posParidade;
        }
    }

    uint8_t paridadeTotal = 0;
    for (uint8_t pos = 0; pos < BITS_FISICOS; ++pos) {
        paridadeTotal ^= (uint8_t)((palavraRecebida >> pos) & 1UL);
    }

    if (sindromeSaida != NULL) *sindromeSaida = sindrome;
    if (paridadeGlobalSaida != NULL) *paridadeGlobalSaida = paridadeTotal;

    uint32_t palavraCorrigida = palavraRecebida;
    StatusSECDED status = ECC_OK;

    if (sindrome == 0 && paridadeTotal == 0) {
        status = ECC_OK;
    }
    else if (paridadeTotal == 1) {
        if (sindrome > 23) {
            status = ECC_DED_ERRO_DUPLO;
        } else {
            palavraCorrigida ^= (1UL << sindrome);
            status = ECC_SEC_CORRIGIDO;
        }
    }
    else {
        status = ECC_DED_ERRO_DUPLO;
    }

    if (palavraFisicaCorrigida != NULL) *palavraFisicaCorrigida = palavraCorrigida & MASCARA_FISICA;
    if (dados18Saida != NULL) *dados18Saida = extrairDados18(palavraCorrigida);

    return status;
}

// =============================== E/S e RGB ===================================
void definirCorRGB(uint8_t indiceBomba, CorRGB cor) {
    if (indiceBomba >= 3) return;

    switch (cor) {
        case RGB_VERMELHO: // Vermelho para nível crítico
            digitalWrite(PIN_RGB_R[indiceBomba], HIGH);
            digitalWrite(PIN_RGB_G[indiceBomba], LOW);
            break;

        case RGB_AMARELO:  // Amarelo (R + G) para nível razoável
            digitalWrite(PIN_RGB_R[indiceBomba], HIGH);
            digitalWrite(PIN_RGB_G[indiceBomba], HIGH);
            break;

        case RGB_VERDE:    // Verde para nível cheio
            digitalWrite(PIN_RGB_R[indiceBomba], LOW);
            digitalWrite(PIN_RGB_G[indiceBomba], HIGH);
            break;

        case RGB_OFF:
        default:
            digitalWrite(PIN_RGB_R[indiceBomba], LOW);
            digitalWrite(PIN_RGB_G[indiceBomba], LOW);
            break;
    }
}

void atualizarLEDNivel(uint8_t indiceBomba) {
    if (indiceBomba >= 3) return;

    if (!LED_HABILITADO[indiceBomba] || !NIVEL_VALIDO[indiceBomba]) {
        definirCorRGB(indiceBomba, RGB_OFF);
        return;
    }

    uint8_t percentual = NIVEL[indiceBomba];

    if (percentual <= LIMIAR_CRITICO) {
        definirCorRGB(indiceBomba, RGB_VERMELHO);
    } else if (percentual <= LIMIAR_RAZOAVEL) {
        definirCorRGB(indiceBomba, RGB_AMARELO);
    } else {
        definirCorRGB(indiceBomba, RGB_VERDE);
    }
}

void atualizarBuzzer() {
    bool algumAlarme = false;
    for (uint8_t i = 0; i < 3; ++i) {
        if (ALARME_CORRETIVO[i]) {
            algumAlarme = true;
            break;
        }
    }

    digitalWrite(PIN_BUZZER, algumAlarme ? HIGH : LOW);
}

void desligarBombasEAlarmes() {
    for (uint8_t i = 0; i < 3; ++i) {
        BOMBA_LIGADA[i] = false;
        LED_HABILITADO[i] = false;
        ALARME_CORRETIVO[i] = false;

        digitalWrite(PIN_BOMBA[i], LOW);
        definirCorRGB(i, RGB_OFF);
    }

    digitalWrite(PIN_BUZZER, LOW);
}

const bool SEGMENTOS[10][7] = {
    {1,1,1,1,1,1,0}, // 0
    {0,1,1,0,0,0,0}, // 1
    {1,1,0,1,1,0,1}, // 2
    {1,1,1,1,0,0,1}, // 3
    {0,1,1,0,0,1,1}, // 4
    {1,0,1,1,0,1,1}, // 5
    {1,0,1,1,1,1,1}, // 6
    {1,1,1,0,0,0,0}, // 7
    {1,1,1,1,1,1,1}, // 8
    {1,1,1,1,0,1,1}  // 9
};

const bool SEGMENTOS_LETRA_R[7] = {0, 0, 0, 0, 1, 0, 1};

void escreverSegmentosDisplay(const uint8_t pinos[7], const bool segmentos[7]) {
    for (uint8_t i = 0; i < 7; ++i) {
        bool ligado = segmentos[i];
        if (!DISPLAY_ACTIVE_HIGH) ligado = !ligado;
        digitalWrite(pinos[i], ligado ? HIGH : LOW);
    }
}

void escreverDigitoDisplay(const uint8_t pinos[7], uint8_t digito) {
    if (digito > 9) digito = 0;

    escreverSegmentosDisplay(pinos, SEGMENTOS[digito]);
}

void apagarDisplay() {
    for (uint8_t i = 0; i < 7; ++i) {
        digitalWrite(PIN_DISPLAY_DEZENAS[i], DISPLAY_ACTIVE_HIGH ? LOW : HIGH);
        digitalWrite(PIN_DISPLAY_UNIDADES[i], DISPLAY_ACTIVE_HIGH ? LOW : HIGH);
    }
    ultimoPercentual = 0;
    displayAtivo = false;
}

void mostrarPercentual(uint8_t percentual) {
    if (percentual > 99) percentual = 99;

    escreverDigitoDisplay(PIN_DISPLAY_DEZENAS, percentual / 10);
    escreverDigitoDisplay(PIN_DISPLAY_UNIDADES, percentual % 10);

    ultimoPercentual = percentual;
    displayAtivo = true;
}

void mostrarIdentificacaoReservatorio(uint8_t reservatorio) {
    escreverSegmentosDisplay(PIN_DISPLAY_DEZENAS, SEGMENTOS_LETRA_R);
    escreverDigitoDisplay(PIN_DISPLAY_UNIDADES, reservatorio);
}

int lerPercentualAnalogico(uint8_t indiceBomba) {
    if (indiceBomba >= 3) return -1;

    int raw = analogRead(PIN_NIVEL[indiceBomba]);
    int percentual = (raw * 100L + 511L) / 1023L;

    if (percentual < 0) percentual = 0;
    if (percentual > 100) percentual = 100;

    NIVEL[indiceBomba] = (uint8_t)percentual;
    NIVEL_VALIDO[indiceBomba] = true;
    ACC = (int16_t)percentual;

    // Atualiza a cor se o LED deste reservatório estiver ligado
    atualizarLEDNivel(indiceBomba);

    return percentual;
}

void lerNivelEExibir(uint8_t indiceBomba, bool mostrarIdentificacao) {
    int percentual = lerPercentualAnalogico(indiceBomba);
    if (percentual < 0) return;

    if (mostrarIdentificacao) {
        mostrarIdentificacaoReservatorio(indiceBomba + 1);
        delay(1000);
    }

    uint8_t percentualDisplay = percentual > 99 ? 99 : (uint8_t)percentual;
    mostrarPercentual(percentualDisplay);

    Serial.print(F("INFO bomba "));
    Serial.print(indiceBomba + 1);
    Serial.print(F(" -> "));
    Serial.print(percentual);
    Serial.print(F("% | display="));
    Serial.print(percentualDisplay);
    Serial.println(F("%"));
}

// =============================== MEMORIA ====================================
bool MEMORIA(SinalMemoria sinal) {
    if (MAR >= TAM_MEMORIA) {
        return false;
    }

    switch (sinal) {
        case MEM_LEITURA: {
            uint32_t palavraLida = MEM_PROG[MAR] & MASCARA_FISICA;
            uint32_t palavraCorrigida = 0;
            uint32_t dados18 = 0;

            ECC_STATUS = decodificarSECDED(
                palavraLida,
                &palavraCorrigida,
                &dados18,
                &ECC_SINDROME,
                &ECC_PARIDADE_GLOBAL
            );

            MBR_RAW = palavraCorrigida;
            MBR = dados18 & MASCARA_PALAVRA;

            if (ECC_STATUS == ECC_SEC_CORRIGIDO) {
                MEM_PROG[MAR] = palavraCorrigida;
                CONTADOR_SEC++;

                Serial.print(F("[SECDED-SEC] 1 bit invertido detectado e corrigido em "));
                imprimirEndereco(MAR);
                Serial.print(F(" | Bit fisico corrigido (Sindrome)="));
                Serial.print(ECC_SINDROME);
                Serial.print(F(" | P_total="));
                Serial.println(ECC_PARIDADE_GLOBAL);
                return true;
            }

            if (ECC_STATUS == ECC_DED_ERRO_DUPLO) {
                CONTADOR_DED++;
                Serial.print(F("[SECDED-DED] ERRO DUPLO INrecuperavel em "));
                imprimirEndereco(MAR);
                Serial.print(F(" | Sindrome="));
                Serial.print(ECC_SINDROME);
                Serial.print(F(" | P_total="));
                Serial.println(ECC_PARIDADE_GLOBAL);
                return false;
            }

            return true;
        }

        case MEM_ESCRITA: {
            uint32_t palavraFisica = codificarSECDED(MBR & MASCARA_PALAVRA);
            MEM_PROG[MAR] = palavraFisica;
            MBR_RAW = palavraFisica;
            MEM_OCUPADA[MAR] = true;
            ECC_STATUS = ECC_OK;
            ECC_SINDROME = 0;
            ECC_PARIDADE_GLOBAL = 0;
            return true;
        }

        default:
            return false;
    }
}

void limparMemoria() {
    for (uint16_t i = 0; i < TAM_MEMORIA; ++i) {
        MEM_PROG[i] = 0;
        MEM_OCUPADA[i] = false;
    }
}

uint16_t contarPosicoesCarregadas() {
    uint16_t quantidade = 0;
    for (uint16_t i = 0; i < TAM_MEMORIA; ++i) {
        if (MEM_OCUPADA[i]) quantidade++;
    }
    return quantidade;
}

// ================================ Decoder ===================================
Opcode DECODER() {
    IR &= MASCARA_PALAVRA;

    OPCODE_REG = (IR >> OPCODE_SHIFT) & 0x0F;
    OP1 = (IR >> OPERANDO1_SHIFT) & MASCARA_7_BITS;
    OP2 = IR & MASCARA_7_BITS;

    if (OPCODE_REG <= OP_REG) {
        return (Opcode)OPCODE_REG;
    }

    return OP_INVALID;
}

// ================================ ULA =======================================
void ULA() {
    ULA_RESULTADO = 0;

    switch (ULA_OPERACAO) {
        case ULA_SUBTRACAO:
            ULA_RESULTADO = ULA_A - ULA_B;
            break;

        default:
            break;
    }
}

void atualizarFlagsDaULA() {
    FLAG_L = (ULA_RESULTADO < 0);
    FLAG_Z = (ULA_RESULTADO == 0);
    FLAG_G = (ULA_RESULTADO > 0);
    COMPARACAO_VALIDA = true;
}

int8_t decodificarImediato7(uint8_t valor) {
    return (valor & 0x40) ? (int8_t)(valor - 128) : (int8_t)valor;
}

// ============================ Validação da ISA ===============================
bool opcodeUsaBomba(Opcode opcode) {
    return opcode == OP_READ || opcode == OP_ON || opcode == OP_OFF ||
           opcode == OP_ALARM || opcode == OP_LED || opcode == OP_INFO ||
           opcode == OP_SILENCE || opcode == OP_LEDOFF;
}

bool opcodeUsaEndereco(Opcode opcode) {
    return opcode == OP_JMP || opcode == OP_JL || opcode == OP_JE || opcode == OP_JG;
}

bool opcodeUsaSoOP1(Opcode opcode) {
    return opcodeUsaBomba(opcode) || opcodeUsaEndereco(opcode) || opcode == OP_WAIT;
}

bool palavraDecodificadaValida(Opcode opcode, uint8_t op1, uint8_t op2) {
    if (opcode == OP_INVALID) return false;

    switch (opcode) {
        case OP_READ:
        case OP_ON:
        case OP_OFF:
        case OP_ALARM:
        case OP_LED:
        case OP_INFO:
        case OP_SILENCE:
        case OP_LEDOFF:
            if (opcode == OP_INFO) {
                return op1 >= 1 && op1 <= 3 && op2 <= 1;
            }
            return op1 >= 1 && op1 <= 3 && op2 == 0;

        case OP_CMP:
            return op1 >= 1 && op1 <= 3 && op2 <= MAX_PERCENTUAL;

        case OP_JMP:
        case OP_JL:
        case OP_JE:
        case OP_JG:
            return op1 < TAM_MEMORIA && op2 == 0;

        case OP_WAIT:
            return op1 <= MAX_WAIT_TICKS && op2 == 0;

        case OP_REG:
            return (op2 == REG_SUBOP_CMP || op2 == REG_SUBOP_JUMP || op2 == REG_SUBOP_SUM) &&
                   (op2 != REG_SUBOP_JUMP || op1 < TAM_MEMORIA);

        case OP_HALT:
            return op1 == 0 && op2 == 0;

        default:
            return false;
    }
}

bool validarDestinoCarregado(uint8_t endereco) {
    return endereco < TAM_MEMORIA && MEM_OCUPADA[endereco];
}

bool validarDestinosDosDesvios() {
    for (uint16_t endereco = 0; endereco < instrucao_atual; ++endereco) {
        if (!MEM_OCUPADA[endereco]) continue;

        uint32_t palavraFisica = MEM_PROG[endereco] & MASCARA_FISICA;
        uint32_t palavra = 0;
        StatusSECDED st = decodificarSECDED(palavraFisica, NULL, &palavra, NULL, NULL);

        if (st == ECC_DED_ERRO_DUPLO) {
            Serial.print(F("ERRO SECDED no endereco "));
            imprimirEndereco((uint8_t)endereco);
            Serial.println(F(": erro duplo detectado na validacao."));
            return false;
        }

        Opcode opcode = (Opcode)((palavra >> OPCODE_SHIFT) & 0x0F);
        uint8_t op1 = (palavra >> OPERANDO1_SHIFT) & MASCARA_7_BITS;
        uint8_t op2 = palavra & MASCARA_7_BITS;

        if (!palavraDecodificadaValida(opcode, op1, op2)) {
            Serial.print(F("ERRO no endereco "));
            imprimirEndereco((uint8_t)endereco);
            Serial.println(F(": palavra invalida para a ISA."));
            return false;
        }

        bool ehDesvioREG = opcode == OP_REG && op2 == REG_SUBOP_JUMP;
        if ((opcodeUsaEndereco(opcode) || ehDesvioREG) && !validarDestinoCarregado(op1)) {
            Serial.print(F("ERRO: destino "));
            imprimirEndereco(op1);
            Serial.print(F(" da instrucao em "));
            imprimirEndereco((uint8_t)endereco);
            Serial.println(F(" nao corresponde a uma posicao carregada."));
            return false;
        }
    }

    return true;
}

// ============================ ASSEMBLY =======================================
int ASSEMBLY(const char *instrucao) {
    if (instrucao == NULL) return -1;

    if (strcmp(instrucao, "CMPREG") == 0 ||
        strcmp(instrucao, "JREG") == 0 ||
        strcmp(instrucao, "REGSUM") == 0) {
        return OP_REG;
    }

    for (uint8_t i = 0; i < 16; ++i) {
        if (strcmp(instrucao, NOME_OPCODE[i]) == 0) {
            return i;
        }
    }

    return -1;
}

bool montarPalavra(const char *mnem, const char *op1Texto, const char *op2Texto, uint32_t *palavraSaida) {
    if (mnem == NULL || palavraSaida == NULL) return false;

    int opcodeInteiro = ASSEMBLY(mnem);
    if (opcodeInteiro < 0) return false;

    Opcode opcode = (Opcode)opcodeInteiro;
    uint8_t op1 = 0;
    uint8_t op2 = 0;
    int valor = 0;

    if (opcode == OP_HALT) {
        if (op1Texto != NULL || op2Texto != NULL) return false;
    }
    else if (opcode == OP_CMP) {
        if (op1Texto == NULL || op2Texto == NULL) return false;

        if (!parseDecimal(op1Texto, 1, 3, &valor)) {
            return false;
        }
        op1 = (uint8_t)valor;

        if (!parseDecimal(op2Texto, 0, MAX_PERCENTUAL, &valor)) {
            return false;
        }
        op2 = (uint8_t)valor;
    }
    else if (opcode == OP_INFO) {
        if (op1Texto == NULL || op2Texto == NULL) return false;

        if (!parseDecimal(op1Texto, 1, 3, &valor)) {
            return false;
        }
        op1 = (uint8_t)valor;

        if (!parseDecimal(op2Texto, 0, 1, &valor)) {
            return false;
        }
        op2 = (uint8_t)valor;
    }
    else if (opcode == OP_REG) {
        if (op1Texto == NULL || op2Texto != NULL) {
            return false;
        }

        if (strcmp(mnem, "JREG") == 0) {
            if (!parseEnderecoHex(op1Texto, &op1)) return false;
            op2 = REG_SUBOP_JUMP;
        } else {
            if (strcmp(mnem, "CMPREG") != 0 && strcmp(mnem, "REGSUM") != 0) return false;
            if (!parseSigned7(op1Texto, &valor)) return false;
            op1 = (uint8_t)(valor < 0 ? valor + 128 : valor);
            op2 = strcmp(mnem, "CMPREG") == 0 ? REG_SUBOP_CMP : REG_SUBOP_SUM;
        }
    }
    else if (opcodeUsaEndereco(opcode)) {
        if (op1Texto == NULL || op2Texto != NULL) return false;

        if (!parseEnderecoHex(op1Texto, &op1)) {
            return false;
        }
    }
    else if (opcode == OP_WAIT) {
        if (op1Texto == NULL || op2Texto != NULL) return false;

        if (!parseDecimal(op1Texto, 0, MAX_WAIT_TICKS, &valor)) {
            return false;
        }
        op1 = (uint8_t)valor;
    }
    else if (opcodeUsaBomba(opcode)) {
        if (op1Texto == NULL || op2Texto != NULL) return false;

        if (!parseDecimal(op1Texto, 1, 3, &valor)) {
            return false;
        }
        op1 = (uint8_t)valor;
    }
    else {
        return false;
    }

    *palavraSaida = (((uint32_t)opcode & 0x0FUL) << OPCODE_SHIFT) |
                    (((uint32_t)op1 & MASCARA_7_BITS) << OPERANDO1_SHIFT) |
                    ((uint32_t)op2 & MASCARA_7_BITS);

    *palavraSaida &= MASCARA_PALAVRA;
    return true;
}

bool ASSEMBLER(char *instrucao) {
    if (instrucao == NULL) return false;

    removerComentario(instrucao);
    trimInPlace(instrucao);
    if (textoVazio(instrucao)) {
        return false;
    }

    if (MODO != MODO_CARGA) {
        Serial.println(F("ERRO: novas instrucoes so podem ser carregadas apos LOAD."));
        return false;
    }

    if (instrucao_atual >= TAM_MEMORIA) {
        Serial.println(F("ERRO: memoria de programa cheia."));
        return false;
    }

    char copia[LINE_BUFFER_SIZE];
    strncpy(copia, instrucao, sizeof(copia) - 1);
    copia[sizeof(copia) - 1] = '\0';

    char *token = strtok(copia, " \t,");
    if (token == NULL) return false;

    char *mnem = token;
    char *op1Texto = strtok(NULL, " \t,");
    char *op2Texto = strtok(NULL, " \t,");
    char *extra = strtok(NULL, " \t,");

    if (extra != NULL) {
        Serial.println(F("ERRO: excesso de operandos."));
        return false;
    }

    uint32_t palavra = 0;

    if (!montarPalavra(mnem, op1Texto, op2Texto, &palavra)) {
        Serial.println(F("ERRO: instrucao ou operandos invalidos."));
        return false;
    }

    MAR = (uint8_t)instrucao_atual;
    MBR = palavra;

    if (!MEMORIA(MEM_ESCRITA)) {
        Serial.println(F("ERRO: falha ao gravar memoria."));
        return false;
    }
    Serial.print(F("Montado em "));
    imprimirEndereco((uint8_t)instrucao_atual);
    Serial.print(F(" | "));
    Serial.print(mnem);
    if (op1Texto != NULL) {
        Serial.print(' ');
        Serial.print(op1Texto);
    }
    if (op2Texto != NULL) {
        Serial.print(F(", "));
        Serial.print(op2Texto);
    }
    Serial.print(F(" | ISA[18b]="));
    imprimirBinario18(palavra);
    Serial.print(F(" | SECDED[24b]="));
    imprimirBinario24(MBR_RAW);
    Serial.println();

    instrucao_atual++;
    persistirPrograma();
    return true;
}

// ============================== Execução ====================================
void resetarRegistradoresExecucao() {
    PC = 0;
    MAR = 0;
    MBR = 0;
    MBR_RAW = 0;
    IR = 0;
    ACC = 0;
    REG = 0;
    OPCODE_REG = OP_REG;
    OP1 = 0;
    OP2 = 0;

    ECC_SINDROME = 0;
    ECC_PARIDADE_GLOBAL = 0;
    ECC_STATUS = ECC_OK;

    for (uint8_t i = 0; i < 3; ++i) {
        NIVEL[i] = 0;
        NIVEL_VALIDO[i] = false;
    }

    FLAG_L = false;
    FLAG_Z = false;
    FLAG_G = false;
    COMPARACAO_VALIDA = false;
    FLAG_REG = false;
    COMPARACAO_REG_VALIDA = false;

    ULA_OPERACAO = ULA_NENHUMA;
    ULA_A = 0;
    ULA_B = 0;
    ULA_RESULTADO = 0;

    stepSolicitado = false;
    waitTermino = 0;
    modoAposWait = MODO_PARADO;
}

void resetarSistemaParaCarga() {
    desligarBombasEAlarmes();
    apagarDisplay();
    limparMemoria();
    limparProgramaPersistido();
    resetarRegistradoresExecucao();

    CONTADOR_SEC = 0;
    CONTADOR_DED = 0;
    instrucao_atual = 0;
    programaFinalizado = false;
    MODO = MODO_CARGA;
    FASE = FASE_OCIOSA;
    CLOCK = false;

    Serial.println(F("LOAD concluido: sistema reinicializado e memoria limpa."));
}

void prepararNovaExecucao() {
    desligarBombasEAlarmes();
    apagarDisplay();
    resetarRegistradoresExecucao();
    MODO = MODO_STEP;
    FASE = FASE_OCIOSA;
}

void erroExecucao(const char *mensagem) {
    MODO = MODO_ERRO;
    FASE = FASE_OCIOSA;
    stepSolicitado = false;

    desligarBombasEAlarmes();

    Serial.print(F("ERRO DE EXECUCAO: "));
    Serial.println(mensagem);
}

bool avancarPC() {
    if (PC >= TAM_MEMORIA - 1) {
        erroExecucao("ultima posicao atingida sem HALT ou desvio valido");
        return false;
    }

    PC++;
    return true;
}

bool validarBombaOperando(uint8_t bomba) {
    if (bomba < 1 || bomba > 3) {
        erroExecucao("identificacao de bomba invalida");
        return false;
    }
    return true;
}

void executarREAD(uint8_t bomba) {
    if (!validarBombaOperando(bomba)) return;
    if (lerPercentualAnalogico(bomba - 1) < 0) {
        erroExecucao("falha na leitura analogica");
        return;
    }

    avancarPC();
}

void executarON(uint8_t bomba) {
    if (!validarBombaOperando(bomba)) return;

    BOMBA_LIGADA[bomba - 1] = true;
    digitalWrite(PIN_BOMBA[bomba - 1], HIGH);
    avancarPC();
}

void executarOFF(uint8_t bomba) {
    if (!validarBombaOperando(bomba)) return;

    BOMBA_LIGADA[bomba - 1] = false;
    digitalWrite(PIN_BOMBA[bomba - 1], LOW);
    avancarPC();
}

void executarALARM(uint8_t bomba) {
    if (!validarBombaOperando(bomba)) return;

    ALARME_CORRETIVO[bomba - 1] = true;
    atualizarBuzzer();

    Serial.print(F("ALARM: bomba "));
    Serial.print(bomba);
    Serial.println(F(" em manutencao corretiva."));

    avancarPC();
}

void executarLED(uint8_t bomba) {
    if (!validarBombaOperando(bomba)) return;

    uint8_t idx = bomba - 1;
    LED_HABILITADO[idx] = true;
    atualizarLEDNivel(idx);
    avancarPC();
}

void executarINFO(uint8_t bomba, uint8_t mostrarIdentificacao) {
    if (!validarBombaOperando(bomba)) return;

    lerNivelEExibir(bomba - 1, mostrarIdentificacao == 1);
    avancarPC();
}

void executarSILENCE(uint8_t bomba) {
    if (!validarBombaOperando(bomba)) return;

    ALARME_CORRETIVO[bomba - 1] = false;
    atualizarBuzzer();
    avancarPC();
}

void executarLEDOFF(uint8_t bomba) {
    if (!validarBombaOperando(bomba)) return;

    uint8_t idx = bomba - 1;
    LED_HABILITADO[idx] = false;
    definirCorRGB(idx, RGB_OFF);
    avancarPC();
}

void executarCMP(uint8_t bomba, uint8_t limite) {
    if (!validarBombaOperando(bomba)) return;

    uint8_t indice = bomba - 1;

    if (!NIVEL_VALIDO[indice]) {
        erroExecucao("CMP sem leitura valida para a bomba indicada");
        return;
    }

    ULA_A = (int16_t)NIVEL[indice];
    ULA_B = (int16_t)limite;
    ULA_OPERACAO = ULA_SUBTRACAO;

    ULA();

    ACC = ULA_RESULTADO;
    atualizarFlagsDaULA();

    avancarPC();
}

void executarCMPREG(int8_t limite) {
    FLAG_REG = REG < limite;
    COMPARACAO_REG_VALIDA = true;
    avancarPC();
}

void executarREGSUM(int8_t valor) {
    REG += valor;
    avancarPC();
}

void executarJMP(uint8_t destino);

void executarJREG(uint8_t destino) {
    if (!COMPARACAO_REG_VALIDA) {
        erroExecucao("JREG sem CMPREG valido");
        return;
    }

    if (FLAG_REG) {
        executarJMP(destino);
    } else {
        avancarPC();
    }
}

void executarJMP(uint8_t destino) {
    if (!validarDestinoCarregado(destino)) {
        erroExecucao("JMP para posicao nao carregada");
        return;
    }

    PC = destino;
}

void executarCondicional(Opcode opcode, uint8_t destino) {
    if (!COMPARACAO_VALIDA) {
        erroExecucao("desvio condicional sem comparacao valida");
        return;
    }

    bool condicao = false;

    switch (opcode) {
        case OP_JL: condicao = FLAG_L; break;
        case OP_JE: condicao = FLAG_Z; break;
        case OP_JG: condicao = FLAG_G; break;
        default:
            erroExecucao("opcode condicional invalido");
            return;
    }

    if (condicao) {
        if (!validarDestinoCarregado(destino)) {
            erroExecucao("desvio condicional para posicao nao carregada");
            return;
        }
        PC = destino;
    } else {
        avancarPC();
    }
}

void executarWAIT(uint8_t ticks) {
    if (ticks > MAX_WAIT_TICKS) {
        erroExecucao("tempo de WAIT fora do limite definido pela ISA");
        return;
    }

    if (!avancarPC()) return;

    waitTermino = millis() + ((uint32_t)ticks * WAIT_MS);
    modoAposWait = MODO;
    MODO = MODO_WAIT;
}

void executarHALT() {
    MODO = MODO_HALT;
    Serial.println(F("HALT: execucao encerrada; saídas mantidas."));
}

void imprimirMnemonicoDecodificado(Opcode opcode, uint8_t op1, uint8_t op2) {
    if (opcode == OP_INVALID) {
        Serial.print(F("INVALID"));
        return;
    }

    if (opcode == OP_REG) {
        if (op2 == REG_SUBOP_CMP) Serial.print(F("CMPREG "));
        else if (op2 == REG_SUBOP_JUMP) {
            Serial.print(F("JREG "));
            imprimirEndereco(op1);
            return;
        } else if (op2 == REG_SUBOP_SUM) Serial.print(F("REGSUM "));
        else {
            Serial.print(F("REG "));
            Serial.print(op1);
            return;
        }
        Serial.print(decodificarImediato7(op1));
        return;
    }

    Serial.print(NOME_OPCODE[opcode]);

    if (opcode == OP_HALT) {
        return;
    }

    Serial.print(' ');

    if (opcodeUsaEndereco(opcode)) {
        imprimirEndereco(op1);
    }
    else if (opcode == OP_CMP) {
        Serial.print(op1);
        Serial.print(F(", "));
        Serial.print(op2);
    }
    else {
        Serial.print(op1);
    }
}

void imprimirEstadosSaida() {
    Serial.print(F("BOMBAS=["));
    for (uint8_t i = 0; i < 3; ++i) {
        Serial.print(BOMBA_LIGADA[i] ? '1' : '0');
        if (i < 2) Serial.print(',');
    }
    Serial.print(F("] LED_RGB=["));
    for (uint8_t i = 0; i < 3; ++i) {
        if (!LED_HABILITADO[i]) {
            Serial.print(F("OFF"));
        } else if (NIVEL[i] <= LIMIAR_CRITICO) {
            Serial.print(F("RED"));
        } else if (NIVEL[i] <= LIMIAR_RAZOAVEL) {
            Serial.print(F("YEL"));
        } else {
            Serial.print(F("GRN"));
        }
        if (i < 2) Serial.print(',');
    }
    Serial.print(F("] ALARM=["));
    for (uint8_t i = 0; i < 3; ++i) {
        Serial.print(ALARME_CORRETIVO[i] ? '1' : '0');
        if (i < 2) Serial.print(',');
    }
    Serial.println(F("]"));
}

void imprimirTrace(uint8_t enderecoExecutado, Opcode opcode, uint8_t op1, uint8_t op2, bool mostrarProximoPC) {
    Serial.println(F("--------------------------------------------------"));
    Serial.print(F("END exec=0x"));
    imprimirHex2(enderecoExecutado);
    Serial.println();

    Serial.print(F("SECDED[24b]="));
    imprimirBinario24(MBR_RAW);
    Serial.print(F(" | Status="));
    Serial.print(NOME_ECC[ECC_STATUS]);
    Serial.print(F(" (S="));
    Serial.print(ECC_SINDROME);
    Serial.print(F(", P0="));
    Serial.print(ECC_PARIDADE_GLOBAL);
    Serial.println(')');

    Serial.print(F("IR[18b]="));
    imprimirBinario18(IR);
    Serial.println();

    Serial.print(F("Instrucao="));
    imprimirMnemonicoDecodificado(opcode, op1, op2);
    Serial.println();

    Serial.print(F("ACC decimal="));
    Serial.println(ACC);
    Serial.print(F(" "));
    imprimirACC18();
    Serial.println();

    Serial.print(F("FLAGS: L="));
    Serial.print(FLAG_L ? 1 : 0);
    Serial.print(F(" Z="));
    Serial.print(FLAG_Z ? 1 : 0);
    Serial.print(F(" G="));
    Serial.print(FLAG_G ? 1 : 0);
    Serial.print(F(" validCmp="));
    Serial.println(COMPARACAO_VALIDA ? 1 : 0);
    Serial.print(F("REG decimal="));
    Serial.println(REG);
    Serial.print(F("FLAG_REG="));
    Serial.print(FLAG_REG ? 1 : 0);
    Serial.print(F(" validCmpReg="));
    Serial.println(COMPARACAO_REG_VALIDA ? 1 : 0);

    Serial.print(F("NIVEIS: ["));
    for (uint8_t i = 0; i < 3; ++i) {
        Serial.print(NIVEL[i]);
        Serial.print(NIVEL_VALIDO[i] ? '%' : '?');
        if (i < 2) Serial.print(F(", "));
    }
    Serial.println(']');

    imprimirEstadosSaida();

    if (mostrarProximoPC && MODO != MODO_HALT && MODO != MODO_ERRO) {
        Serial.print(F("Proximo PC="));
        imprimirEndereco(PC);
        Serial.println();
    } else {
        Serial.print(F("Estado="));
        Serial.println(nomeModoAtual());
    }
}

// ================================ UC ========================================
void UC() {
    if (MODO != MODO_STEP && MODO != MODO_AUTO) {
        return;
    }

    if (PC >= TAM_MEMORIA) {
        erroExecucao("PC fora da memoria de programa");
        return;
    }

    if (!MEM_OCUPADA[PC]) {
        erroExecucao("tentativa de executar uma posicao de memoria nao carregada");
        return;
    }

    uint8_t enderecoExecutado = PC;

    // ------------------------------ BUSCA ------------------------------------
    FASE = FASE_BUSCA;

    MAR = PC;
    if (!MEMORIA(MEM_LEITURA)) {
        if (ECC_STATUS == ECC_DED_ERRO_DUPLO) {
            erroExecucao("SECDED detectou ERRO DUPLO (DED) na memoria de programa");
        } else {
            erroExecucao("falha na leitura da memoria durante a busca");
        }
        return;
    }

    MBR &= MASCARA_PALAVRA;

    // --------------------------- DECODIFICA ----------------------------------
    FASE = FASE_DECODIFICA;

    IR = MBR;
    Opcode opcode = DECODER();

    if (!palavraDecodificadaValida(opcode, OP1, OP2)) {
        erroExecucao("opcode/campos invalidos na palavra armazenada");
        return;
    }

    // ----------------------------- EXECUTA -----------------------------------
    FASE = FASE_EXECUTA;
    bool emitirTrace = MODO != MODO_AUTO;

    switch (opcode) {
        case OP_READ:    executarREAD(OP1); break;
        case OP_ON:      executarON(OP1); break;
        case OP_OFF:     executarOFF(OP1); break;
        case OP_ALARM:   executarALARM(OP1); break;
        case OP_LED:     executarLED(OP1); break;
        case OP_INFO:    executarINFO(OP1, OP2); break;
        case OP_SILENCE: executarSILENCE(OP1); break;
        case OP_LEDOFF:  executarLEDOFF(OP1); break;
        case OP_CMP:     executarCMP(OP1, OP2); break;
        case OP_JMP:     executarJMP(OP1); break;
        case OP_JL:      executarCondicional(OP_JL, OP1); break;
        case OP_JE:      executarCondicional(OP_JE, OP1); break;
        case OP_JG:      executarCondicional(OP_JG, OP1); break;
        case OP_WAIT:    executarWAIT(OP1); break;
        case OP_HALT:    executarHALT(); break;
        case OP_REG:
            if (OP2 == REG_SUBOP_CMP) executarCMPREG(decodificarImediato7(OP1));
            else if (OP2 == REG_SUBOP_JUMP) executarJREG(OP1);
            else if (OP2 == REG_SUBOP_SUM) executarREGSUM(decodificarImediato7(OP1));
            else erroExecucao("subopcode REG desconhecido");
            break;
        default:         erroExecucao("opcode desconhecido"); return;
    }

    if (MODO == MODO_ERRO) {
        FASE = FASE_OCIOSA;
        return;
    }

    CLOCK = !CLOCK;

    if (emitirTrace) {
        bool mostrarProximoPC = (MODO != MODO_HALT && MODO != MODO_ERRO);
        imprimirTrace(enderecoExecutado, opcode, OP1, OP2, mostrarProximoPC);
    }

    FASE = FASE_OCIOSA;
}

// =========================== Monitor / comandos ==============================
void comandoMEM(char *comando) {
    uint8_t inicio = 0;
    uint8_t fim = TAM_MEMORIA - 1;

    char copia[LINE_BUFFER_SIZE];
    strncpy(copia, comando, sizeof(copia) - 1);
    copia[sizeof(copia) - 1] = '\0';

    char *token = strtok(copia, " \t"); // MEM
    token = strtok(NULL, " \t");

    if (token != NULL) {
        if (!parseEnderecoHex(token, &inicio)) {
            Serial.println(F("ERRO: endereco inicial invalido. Use 0x00..0x7F."));
            return;
        }

        token = strtok(NULL, " \t");
        if (token == NULL) {
            Serial.println(F("ERRO: informe o endereco final."));
            return;
        }

        if (!parseEnderecoHex(token, &fim)) {
            Serial.println(F("ERRO: endereco final invalido. Use 0x00..0x7F."));
            return;
        }

        if (inicio > fim) {
            Serial.println(F("ERRO: intervalo invertido."));
            return;
        }

        if (strtok(NULL, " \t") != NULL) {
            Serial.println(F("ERRO: excesso de argumentos em MEM."));
            return;
        }
    }

    Serial.print(F("Posicoes carregadas: "));
    Serial.println(contarPosicoesCarregadas());
    Serial.println(F("END  | PALAVRA FISICA SECDED (24b) | DADOS ISA (18b)    | ECC STATUS"));

    for (uint16_t endereco = inicio; endereco <= fim; ++endereco) {
        uint32_t palavraFisica = MEM_PROG[endereco] & MASCARA_FISICA;
        uint32_t dados18 = 0;
        uint8_t sind = 0;
        uint8_t pglob = 0;
        StatusSECDED st = decodificarSECDED(palavraFisica, NULL, &dados18, &sind, &pglob);

        Serial.print(F("0x"));
        imprimirHex2((uint8_t)endereco);
        Serial.print(F(" | "));
        imprimirBinario24(palavraFisica);
        Serial.print(F("    | "));
        imprimirBinario18(dados18);
        Serial.print(F(" | "));
        if (!MEM_OCUPADA[endereco] && palavraFisica == 0) {
            Serial.println(F("VAZIA"));
        } else {
            Serial.print(NOME_ECC[st]);
            if (st != ECC_OK) {
                Serial.print(F(" [S="));
                Serial.print(sind);
                Serial.print(F(",P0="));
                Serial.print(pglob);
                Serial.print(']');
            }
            Serial.println();
        }
    }
}

void comandoFLIP(char *comando) {
    char copia[LINE_BUFFER_SIZE];
    strncpy(copia, comando, sizeof(copia) - 1);
    copia[sizeof(copia) - 1] = '\0';

    char *token = strtok(copia, " \t"); // FLIP
    char *endTexto = strtok(NULL, " \t");
    char *bitTexto = strtok(NULL, " \t");
    char *extra = strtok(NULL, " \t");

    if (endTexto == NULL || bitTexto == NULL || extra != NULL) {
        Serial.println(F("ERRO: uso correto -> FLIP 0x00 <bit 0..23>"));
        return;
    }

    uint8_t endereco = 0;
    if (!parseEnderecoHex(endTexto, &endereco)) {
        Serial.println(F("ERRO: endereco invalido. Use 0x00..0x7F."));
        return;
    }

    int bit = 0;
    if (!parseDecimal(bitTexto, 0, BITS_FISICOS - 1, &bit)) {
        Serial.println(F("ERRO: bit invalido. Informe um indice fisico de 0 a 23."));
        return;
    }

    MEM_PROG[endereco] ^= (1UL << bit);
    MEM_PROG[endereco] &= MASCARA_FISICA;

    uint32_t dadosExtraidos = 0;
    uint8_t sind = 0;
    uint8_t pglob = 0;
    StatusSECDED st = decodificarSECDED(MEM_PROG[endereco], NULL, &dadosExtraidos, &sind, &pglob);

    Serial.print(F("FLIP aplicado em "));
    imprimirEndereco(endereco);
    Serial.print(F(" no bit fisico "));
    Serial.print(bit);
    Serial.print(F(" | SECDED[24b]="));
    imprimirBinario24(MEM_PROG[endereco]);
    Serial.print(F(" | Diagnostico esperado: "));
    Serial.print(NOME_ECC[st]);
    Serial.print(F(" (S="));
    Serial.print(sind);
    Serial.print(F(", P0="));
    Serial.print(pglob);
    Serial.println(')');
}

void comandoSTATUS() {
    Serial.println(F("================ STATUS ================"));
    Serial.print(F("Modo: "));
    Serial.println(nomeModoAtual());

    Serial.print(F("Fase UC: "));
    switch (FASE) {
        case FASE_BUSCA: Serial.println(F("BUSCA")); break;
        case FASE_DECODIFICA: Serial.println(F("DECODIFICA")); break;
        case FASE_EXECUTA: Serial.println(F("EXECUTA")); break;
        default: Serial.println(F("OCIOSA")); break;
    }

    Serial.print(F("Clock: "));
    Serial.println(CLOCK ? 1 : 0);

    Serial.print(F("Ponteiro carga: "));
    if (instrucao_atual < TAM_MEMORIA) {
        imprimirEndereco((uint8_t)instrucao_atual);
    } else {
        Serial.print(F("128 (memoria cheia)"));
    }
    Serial.println();

    Serial.print(F("Posicoes ocupadas: "));
    Serial.println(contarPosicoesCarregadas());

    Serial.print(F("PC="));
    if (PC < TAM_MEMORIA) imprimirEndereco(PC);
    else Serial.print(F("fora-da-memoria"));
    Serial.println();

    Serial.print(F("MAR="));
    if (MAR < TAM_MEMORIA) imprimirEndereco(MAR);
    else Serial.print(F("0x"));
    if (MAR >= TAM_MEMORIA) Serial.print(MAR, HEX);
    Serial.println();

    Serial.print(F("MBR_RAW[24b]="));
    imprimirBinario24(MBR_RAW);
    Serial.println();

    Serial.print(F("MBR[18b]="));
    imprimirBinario18(MBR);
    Serial.println();

    Serial.print(F("IR[18b]="));
    imprimirBinario18(IR);
    Serial.println();

    Serial.print(F("SECDED Ultimo Acesso: "));
    Serial.print(NOME_ECC[ECC_STATUS]);
    Serial.print(F(" | Sindrome="));
    Serial.print(ECC_SINDROME);
    Serial.print(F(" | P0="));
    Serial.print(ECC_PARIDADE_GLOBAL);
    Serial.print(F(" | Total SEC="));
    Serial.print(CONTADOR_SEC);
    Serial.print(F(" | Total DED="));
    Serial.println(CONTADOR_DED);

    Serial.print(F("OPCODE="));
    if (OPCODE_REG <= OP_REG) {
        Serial.print(OPCODE_REG, BIN);
        Serial.print(F(" ("));
        Serial.print(NOME_OPCODE[OPCODE_REG]);
        Serial.println(')');
    } else {
        Serial.println(F("1111 (INVALIDO)"));
    }

    Serial.print(F("OP1="));
    Serial.println(OP1);
    Serial.print(F("OP2="));
    Serial.println(OP2);

    Serial.print(F("ACC="));
    Serial.println(ACC);
    Serial.print(F(" "));
    imprimirACC18();
    Serial.println();

    Serial.print(F("FLAGS: L="));
    Serial.print(FLAG_L ? 1 : 0);
    Serial.print(F(" Z="));
    Serial.print(FLAG_Z ? 1 : 0);
    Serial.print(F(" G="));
    Serial.print(FLAG_G ? 1 : 0);
    Serial.print(F(" validCmp="));
    Serial.println(COMPARACAO_VALIDA ? 1 : 0);
    Serial.print(F("REG="));
    Serial.println(REG);
    Serial.print(F("FLAG_REG="));
    Serial.print(FLAG_REG ? 1 : 0);
    Serial.print(F(" validCmpReg="));
    Serial.println(COMPARACAO_REG_VALIDA ? 1 : 0);

    for (uint8_t i = 0; i < 3; ++i) {
        Serial.print(F("Bomba "));
        Serial.print(i + 1);
        Serial.print(F(": nivel="));
        Serial.print(NIVEL[i]);
        Serial.print(F(" valido="));
        Serial.print(NIVEL_VALIDO[i] ? 1 : 0);
        Serial.print(F(" bomba="));
        Serial.print(BOMBA_LIGADA[i] ? 1 : 0);
        Serial.print(F(" LED_RGB="));
        if (!LED_HABILITADO[i]) {
            Serial.print(F("OFF"));
        } else if (NIVEL[i] <= LIMIAR_CRITICO) {
            Serial.print(F("VERMELHO"));
        } else if (NIVEL[i] <= LIMIAR_RAZOAVEL) {
            Serial.print(F("AMARELO"));
        } else {
            Serial.print(F("VERDE"));
        }
        Serial.print(F(" alarm="));
        Serial.println(ALARME_CORRETIVO[i] ? 1 : 0);
    }

    Serial.print(F("Buzzer="));
    bool buzzerAtivo = false;
    for (uint8_t i = 0; i < 3; ++i) {
        if (ALARME_CORRETIVO[i]) buzzerAtivo = true;
    }
    Serial.println(buzzerAtivo ? 1 : 0);

    Serial.print(F("Display="));
    if (!displayAtivo) {
        Serial.println(F("apagado"));
    } else {
        Serial.print(ultimoPercentual);
        Serial.println(F("%"));
    }

    Serial.println(F("=========================================="));
}

bool programaProntoParaExecucao() {
    if (!programaFinalizado) {
        Serial.println(F("ERRO: finalize a carga com END antes de RUN/AUTO."));
        return false;
    }

    if (instrucao_atual == 0) {
        Serial.println(F("ERRO: programa vazio."));
        return false;
    }

    return true;
}

void comandoLOAD() {
    resetarSistemaParaCarga();
}

void comandoEND() {
    if (MODO != MODO_CARGA) {
        Serial.println(F("ERRO: END somente durante a carga."));
        return;
    }

    if (!validarDestinosDosDesvios()) {
        programaFinalizado = false;
        Serial.println(F("Carga nao finalizada. Corrija iniciando novo LOAD."));
        return;
    }

    programaFinalizado = true;
    resetarRegistradoresExecucao();
    desligarBombasEAlarmes();
    apagarDisplay();
    MODO = MODO_PARADO;
    FASE = FASE_OCIOSA;

    Serial.print(F("END: carga finalizada. "));
    Serial.print(instrucao_atual);
    Serial.println(F(" posicoes ocupadas; pronto para RUN ou AUTO."));
}

void comandoRUN() {
    if (!programaProntoParaExecucao()) return;

    prepararNovaExecucao();
    Serial.println(F("RUN: modo passo a passo. Use STEP ou *."));
}

void comandoAUTO() {
    if (!programaProntoParaExecucao()) return;

    prepararNovaExecucao();
    MODO = MODO_AUTO;
    Serial.println(F("AUTO: execucao continua iniciada em 0x00."));
}

void comandoSTEP() {
    if (MODO == MODO_WAIT) {
        Serial.println(F("ERRO: STEP rejeitado durante WAIT; nao ha enfileiramento."));
        return;
    }

    if (MODO != MODO_STEP) {
        Serial.println(F("ERRO: STEP disponivel somente apos RUN."));
        return;
    }

    stepSolicitado = true;
}

void comandoSTOP() {
    if (MODO == MODO_CARGA) {
        Serial.println(F("STOP: nao ha execucao para interromper durante a carga."));
        return;
    }

    desligarBombasEAlarmes();
    stepSolicitado = false;
    MODO = MODO_PARADO;
    FASE = FASE_OCIOSA;

    Serial.println(F("STOP: execucao/WAIT interrompidos; bombas e alarmes desligados."));
}

void processarLinha(char *linha) {
    if (linha == NULL) return;

    removerComentario(linha);
    trimInPlace(linha);

    if (textoVazio(linha)) {
        return;
    }

    paraMaiusculas(linha);

    if (strcmp(linha, "LOAD") == 0) {
        comandoLOAD();
        return;
    }

    if (strcmp(linha, "END") == 0) {
        comandoEND();
        return;
    }

    if (strcmp(linha, "RUN") == 0) {
        comandoRUN();
        return;
    }

    if (strcmp(linha, "AUTO") == 0) {
        comandoAUTO();
        return;
    }

    if (strcmp(linha, "STEP") == 0 || strcmp(linha, "*") == 0) {
        comandoSTEP();
        return;
    }

    if (strcmp(linha, "STOP") == 0) {
        comandoSTOP();
        return;
    }

    if (strcmp(linha, "STATUS") == 0) {
        comandoSTATUS();
        return;
    }

    if (strncmp(linha, "MEM", 3) == 0 && (linha[3] == '\0' || linha[3] == ' ' || linha[3] == '\t')) {
        comandoMEM(linha);
        return;
    }

    if (strncmp(linha, "FLIP", 4) == 0 && (linha[4] == ' ' || linha[4] == '\t')) {
        comandoFLIP(linha);
        return;
    }

    if (MODO == MODO_CARGA) {
        ASSEMBLER(linha);
        return;
    }

    Serial.println(F("ERRO: comando desconhecido ou instrucao Assembly fora da carga."));
}

void processarMonitorSerial() {
    while (Serial.available() > 0) {
        char c = (char)Serial.read();

        if (c == '\r') {
            continue;
        }

        if (c == '\n') {
            linhaSerial[posLinhaSerial] = '\0';
            processarLinha(linhaSerial);
            posLinhaSerial = 0;
            linhaSerial[0] = '\0';
            continue;
        }

        if (posLinhaSerial < LINE_BUFFER_SIZE - 1) {
            linhaSerial[posLinhaSerial++] = c;
            linhaSerial[posLinhaSerial] = '\0';
        } else {
            posLinhaSerial = 0;
            linhaSerial[0] = '\0';
            Serial.println(F("ERRO: linha longa demais."));
        }
    }
}

void atualizarWAIT() {
    if (MODO != MODO_WAIT) return;

    if ((int32_t)(millis() - waitTermino) >= 0) {
        MODO = modoAposWait;
        FASE = FASE_OCIOSA;

        Serial.println(F("WAIT concluido."));
    }
}

// =============================== Arduino ====================================
void setup() {
    Serial.begin(115200);

    for (uint8_t i = 0; i < 3; ++i) {
        pinMode(PIN_BOMBA[i], OUTPUT);
        pinMode(PIN_NIVEL[i], INPUT);
        pinMode(PIN_RGB_R[i], OUTPUT);
        pinMode(PIN_RGB_G[i], OUTPUT);
    }

    pinMode(PIN_BUZZER, OUTPUT);

    for (uint8_t i = 0; i < 7; ++i) {
        pinMode(PIN_DISPLAY_DEZENAS[i], OUTPUT);
        pinMode(PIN_DISPLAY_UNIDADES[i], OUTPUT);
    }

    desligarBombasEAlarmes();
    apagarDisplay();
    resetarRegistradoresExecucao();

    bool programaRestaurado = restaurarProgramaPersistido();
    MODO = programaRestaurado ? MODO_PARADO : MODO_CARGA;
    programaFinalizado = programaRestaurado;

    Serial.println(F("=========================================================="));
    Serial.println(F("CPU SIMULADA - 18 bits ISA / 24 bits SECDED / 128 palavras"));
    if (programaRestaurado) {
        Serial.print(F("Programa restaurado da EEPROM: "));
        Serial.print(instrucao_atual);
        Serial.println(F(" instrucoes. Use RUN/AUTO para executar ou LOAD para substituir."));
    } else {
        Serial.println(F("Digite LOAD para iniciar uma nova carga."));
    }
    Serial.println(F("Use FLIP 0x00 <0..23> para simular falhas de bit na RAM."));
    Serial.println(F("=========================================================="));
}

void loop() {
    processarMonitorSerial();
    atualizarWAIT();

    if (MODO == MODO_STEP && stepSolicitado) {
        stepSolicitado = false;
        UC();
    }

    if (MODO == MODO_AUTO) {
        UC();
    }
}
