brennoms/Arduino-sistema-embarcado-para-reservatorios/(commit log)

2026-10-02 fea(ArquiteturaSimulada)t: cria script para simular a arquitetura no arduino.
2026-10-02 docs(documentacao_arquitetura.md): Adiciona a documentação de ArquiteturaSimulada.ino
2026-10-02 chore: adiciona diretorio para incluir os testes.
2026-10-19 Implementação de proteção de memória SECDED (Hamming Estendido 24,18) na arquitetura simulada. Adicionadas funções para codificação e decodificação de dados, além de tratamento de erros simples e dup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
2026-10-19 feat: adiciona suporte a LEDs RGB para monitoramento de níveis de reservatórios e atualiza a lógica de controle
2026-10-19 feat: adiciona roteiro e conjunto de instruções de teste para a arquitetura de três bombas
2026-10-22 Adiciona Diagrama de Ligações
2026-10-23 colocado modelo dos displays. adicionado arquivo do diagrama para eventuais modificações
2026-10-29 trocado modelo do transistor e dos leds rgb
2026-10-31 atualiza documentação e pinagem dos displays e LEDs RGB
2026-10-31 corrige pinos de controle e atualiza verificação dos displays no roteiro de testes
2026-10-31 atualiza exibição do percentual nos displays para incluir identificação do reservatório
2026-11-01 adiciona rotina de controle para bombas e alarmes nos reservatórios
2026-11-04 atualiza pinos no script de simulação
2026-11-04 Adiciona documentação do sistema de três bombas
2026-11-04 Revert "Adiciona documentação do sistema de três bombas"
    This reverts commit 06d38832694adf54f117c20dbc570e201603fa05.
2026-11-05 Adiciona novas instruções de registrador e rotina de envio via serial
2026-11-05 Atualiza a descrição do conjunto de instruções para incluir detalhes sobre opcodes estendidos e instruções do registrador geral
2026-11-05 Adiciona arquivo .gitignore e atualiza rotina de envio para ler de arquivo
2026-11-05 Atualiza .gitignore, adiciona requirements.txt e refatora rotina de leitura de linhas no script de envio via serial
2026-11-05 Atualiza instruções INFO para incluir modo de exibição e ajusta documentação correspondente
2026-11-05 Adiciona condição para emissão de trace no modo não automático
2026-11-05 Atualiza .gitignore para incluir log.txt e refatora script de envio para registrar respostas em arquivo de log
2026-11-06 Atualiza documentação e código para refletir mudança de exibição de identificação de reservatórios de 'L1', 'L2', 'L3' para 'r1', 'r2', 'r3'
2026-11-06 adiciona o diagrama de corte para a caixa do projeto
2026-11-08 Adiciona arquivos de créditos e modelo STL para o case do Arduino
2026-11-11 Atualiza documentação e código para incluir persistência de programa na EEPROM e opção de monitoramento no script de envio
2026-11-12 Atualiza README.md com informações detalhadas sobre o projeto, incluindo descrição, funcionamento, componentes principais e instruções de execução.
